rice-eclipse/AFSElec/README.md

This is the official GitHub Repo for Rice ECLIPSE AFS.
