rice-eclipse/AFSElec/IndividualFolders/Tyler/Main/3d models/RP2350A.stp

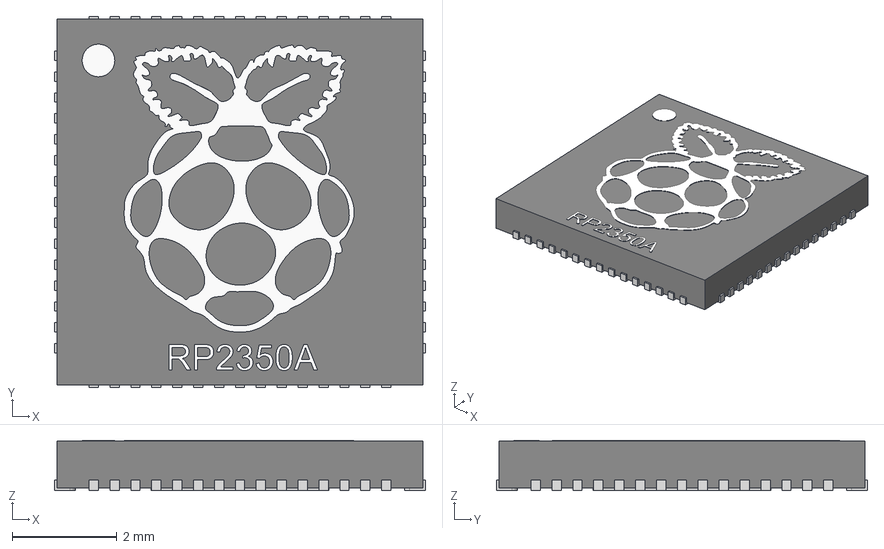
[picture p1: CAD file, 2026-02-24]
IndividualFolders/Tyler/Main/3d models/RP2350A.stp
7.10 x 7.10 x 0.96 mm
