rice-eclipse/AFSElec/IndividualFolders/Tyler/Main/3d models/Same_Sky_MSD-4-A.step

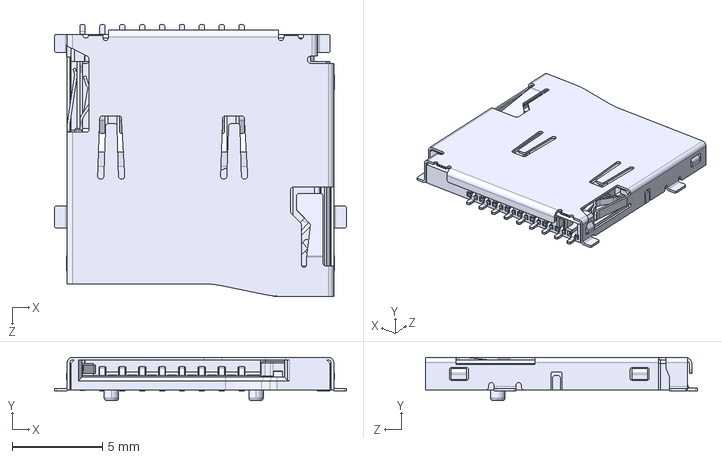
[picture p2: CAD file, 2026-02-20]
IndividualFolders/Tyler/Main/3d models/Same_Sky_MSD-4-A.step
16.1 x 2.40 x 15.0 mm
