rice-eclipse/AFSElec/IndividualFolders/Tyler/Main/3d models/10118193-0001lfc.stp

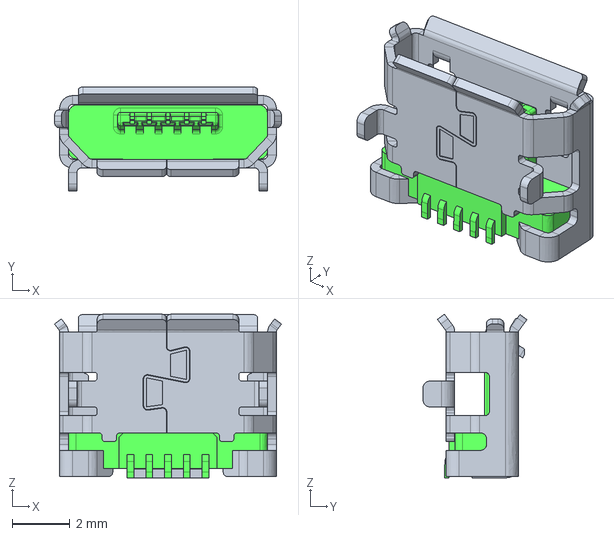
[picture p3: CAD file, 2026-02-20]
IndividualFolders/Tyler/Main/3d models/10118193-0001lfc.stp
7.86 x 3.60 x 5.66 mm
