rice-eclipse/AFSElec/Version2/Version2.kicad_pcb

## KiCad design Version2/Version2.kicad_pcb (2026-09-03)

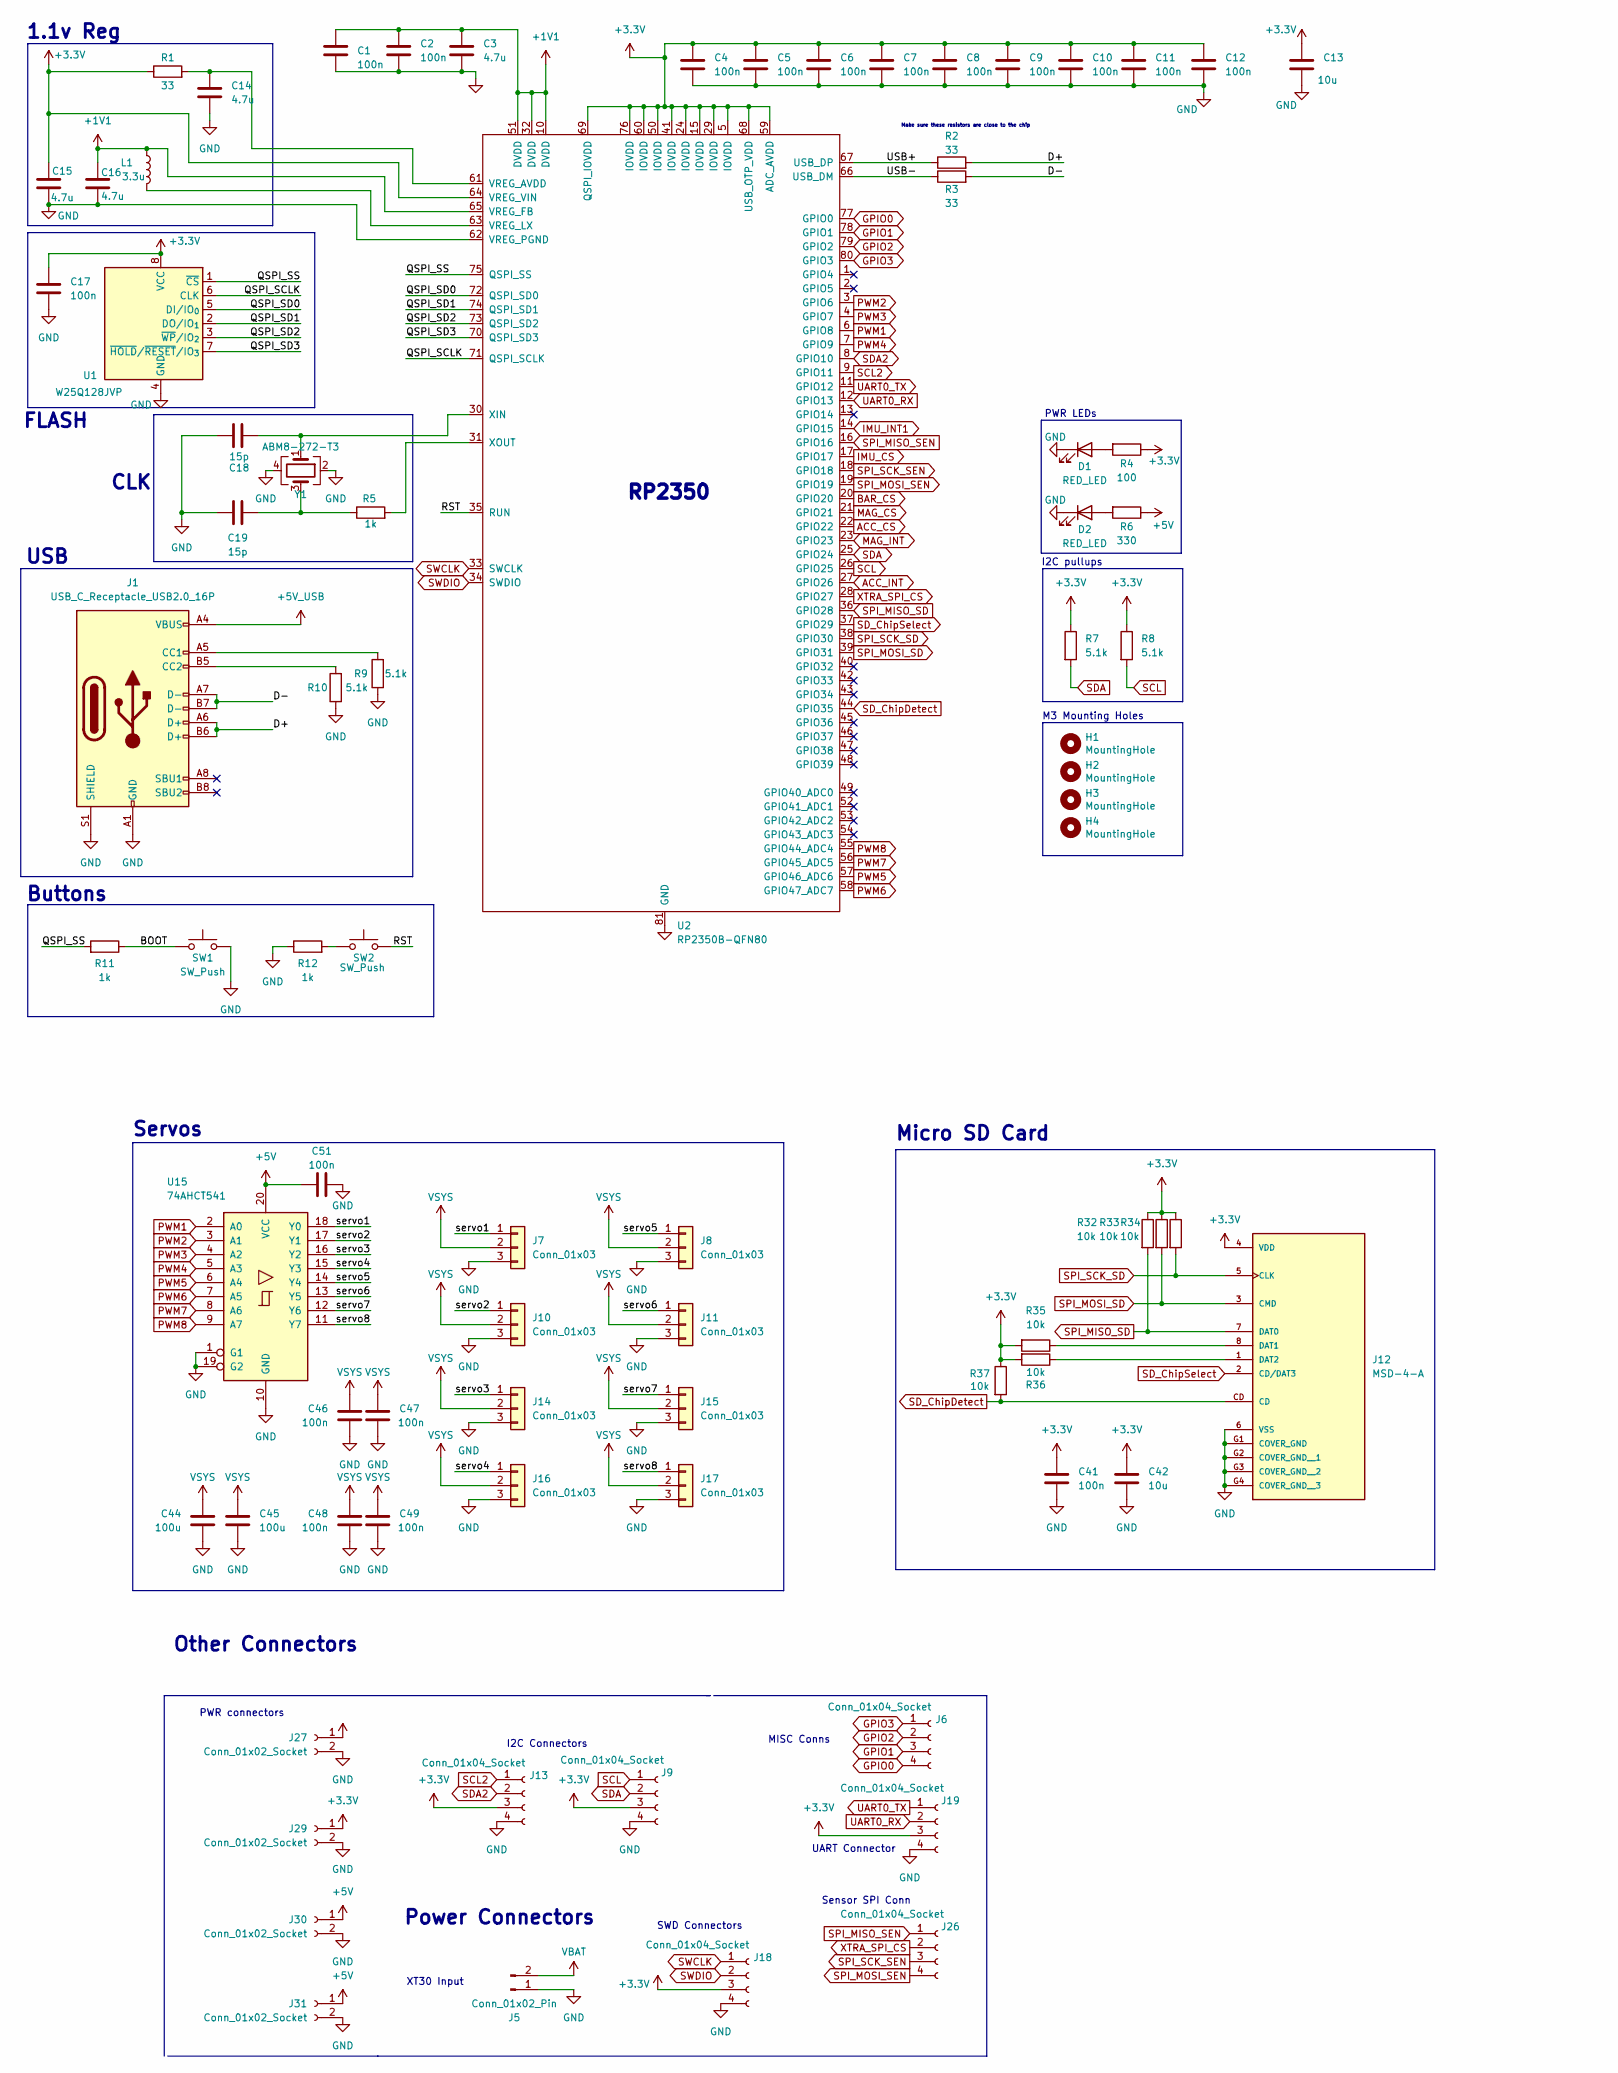
[picture p4: schematic Version2.kicad_sch, part in row 1, column 1]

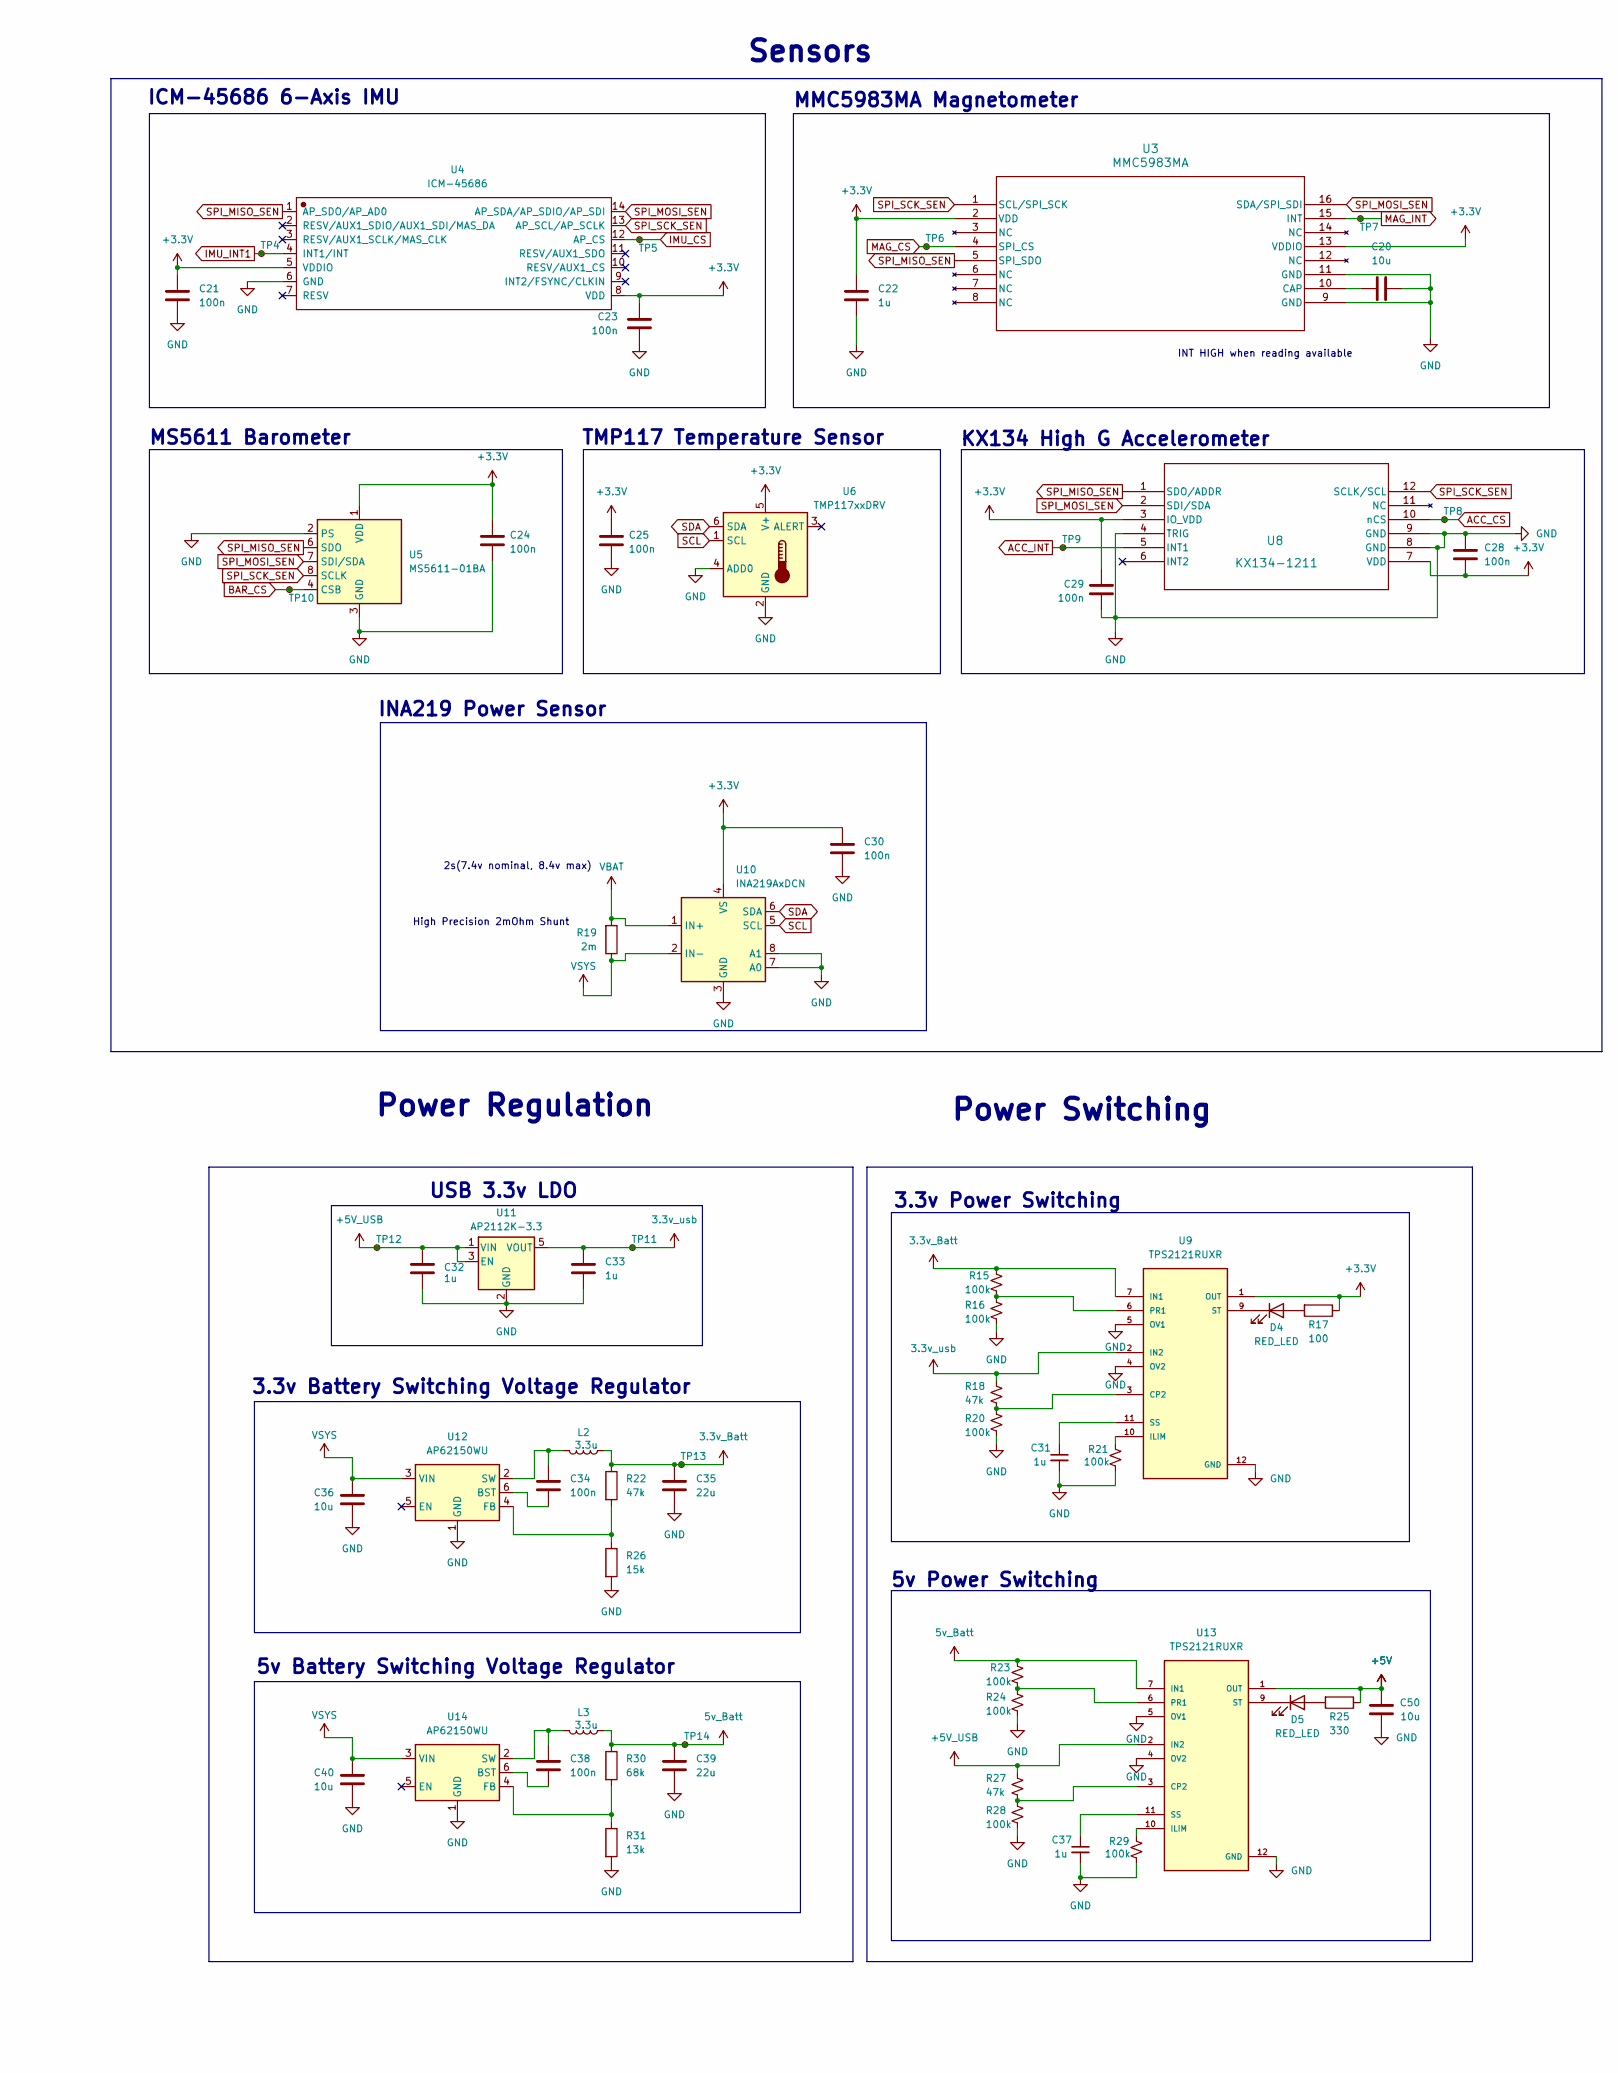
[picture p5: schematic Version2.kicad_sch, part in row 1, column 2]

Parts:
C1, C2, C4, C5, C6, C7, C8, C9, C10, C11, C12, C17, C21, C23, C24, C25, C28, C29, C30, C34, C38, C41, C46, C47, C48, C49, C51: 100n; C_0603_1608Metric; LCSC Part Number C14663
C3, C14, C15, C16: 4.7u; C_0805_2012Metric; LCSC Part Number C1779
C13, C20, C42: 10u; C_0805_2012Metric; LCSC Part Number C15850
C18, C19: 15p; C_0603_1608Metric; LCSC Part Number C1644
C22, C31, C32, C33, C37: 1u; C_0805_2012Metric; LCSC Part Number C28323
C35, C39: 22u; C_0805_2012Metric; LCSC Part Number C45783
C36, C40, C50: 10u; C_0805_2012Metric; JLCPCB Part # C15850
C44, C45: 100u; C_Radial_D5.0mm_H11.0mm_P2.00mm
D1, D2, D4, D5: RED_LED; LED_0805_2012Metric; LCSC Part Number C84256
H1, H2, H3, H4: MountingHole; MountingHole_3.2mm_M3_ISO14580_Pad
J1: USB_C_Receptacle_USB2.0_16P; USB_C_Receptacle_HRO_TYPE-C-31-M-12
J5: Conn_01x02_Pin; AMASS_XT30PW-M_1x02_P2.50mm_Horizontal
J6, J9, J13, J18, J19, J26: Conn_01x04_Socket; JST_PH_B4B-PH-K_1x04_P2.00mm_Vertical
J7, J8, J10, J11, J14, J15, J16, J17: Conn_01x03; PinHeader_1x03_P2.54mm_Vertical
J12: MSD-4-A; CUI_MSD-4-A; PARTREV 1.0; LCSC Part Number C22367949
J27, J29, J30, J31: Conn_01x02_Socket; JST_PH_B2B-PH-K_1x02_P2.00mm_Vertical
L1, L2, L3: 3.3u; AOTA-B201610S3R3-101-T(L_0806_2016metric); LCSC Part Number C42411119
R1, R2, R3: 33; R_0603_1608Metric; LCSC Part Number C23140
R4, R17: 100; R_0603_1608Metric; LCSC Part Number C22775
R5, R11, R12: 1k; R_0603_1608Metric; LCSC Part Number C21190
R6, R25: 330; R_0603_1608Metric; LCSC Part Number C23138
R7, R8, R9, R10: 5.1k; R_0603_1608Metric; LCSC Part Number C23186
R15, R16, R20, R21, R23, R24, R28, R29: 100k; R_0603_1608Metric; LCSC Part Number C25803
R18, R22, R27: 47k; R_0603_1608Metric; LCSC Part Number C25819
R19: 2m; R_1206_3216Metric
R26: 15k; R_0603_1608Metric; LCSC Part Number C22809
R30: 68k; R_0603_1608Metric; LCSC Part Number C23231
R31: 13k; R_0603_1608Metric; LCSC Part Number C22797
R32, R33, R34, R35, R36, R37: 10k; R_0603_1608Metric; LCSC Part Number C25804
SW1, SW2: SW_Push; SW_Push_SPST_NO_Alps_SKRK; LCSC Part Number C115357
TP4, TP5, TP6, TP7, TP8, TP9, TP10, TP11, TP12, TP13, TP14: TestPoint_Small; TestPoint_Pad_1.0x1.0mm
U1: W25Q128JVP; WSON-8-1EP_6x5mm_P1.27mm_EP3.4x4mm; LCSC Part Number C190862
U2: RP2350B-QFN80; QFN-80-1EP_10x10mm_P0.4mm_EP3.4x3.4mm; LCSC Part Number C42415655
U3: MMC5983MA; LGA-16_3x3mm_P0.5mm; LCSC Part Number C404329
U4: ICM-45686; Bosch_LGA-14_3x2.5mm_P0.5mm; Manufacturer Part ICM-45686; LCSC C22459454
U5: MS5611-01BA; LGA-8_3x5mm_P1.25mm; LCSC Part Number C15639
U6: TMP117xxDRV; WSON-6-1EP_2x2mm_P0.65mm_EP1x1.6mm; LCSC Part Number C699536
U8: KX134-1211; LGA-12_2x2mm_P0.5mm; LCSC Part Number C2157908
U9, U13: TPS2121RUXR; Texas_VQFN-HR-12_2x2.5mm_P0.5mm; LCSC Part Number C485916
U10: INA219AxDCN; SOT-23-8; LCSC Part Number SOT-23-8
U11: AP2112K-3.3; SOT-23-5; LCSC Part Number C23380830
U12, U14: AP62150WU; TSOT-23-6; LCSC Part Number C3194237
U15: 74AHCT541; SSOP-20_4.4x6.5mm_P0.65mm; LCSC Part Number C2675635
Y1: ABM8-272-T3; Crystal_SMD_3225-4Pin_3.2x2.5mm; LCSC Part Number C20625731

Connections:
3.3v_Batt: C35.1, L2.1, R15.1, R22.1, TP13.1, U9.7 (IN1)
3.3v_usb: C33.1, R18.1, TP11.1, U9.2 (IN2), U11.5 (VOUT)
5v_Batt: C39.1, L3.1, R23.1, R30.1, TP14.1, U13.7 (IN1)
+1V1: C1.1, C2.1, C3.1, C16.1, L1.1, U2.10 (DVDD), U2.32 (DVDD), U2.51 (DVDD), U2.65 (VREG_FB)
+3.3V: C4.1, C5.1, C6.1, C7.1, C8.1, C9.1, C10.1, C11.1, C12.1, C13.1, C15.1, C17.1, C21.1, C22.2, C23.1, C24.1, C25.1, C28.2, C29.1, C30.1, C41.1, C42.1, J9.3, J12.4 (VDD), J13.3, J18.3, J19.3, J27.1, J29.1, R1.1, R4.1, R7.1, R8.1, R17.1, R32.1, R33.1, R34.1, R35.2, R36.2, R37.1, U1.8 (VCC), U2.5 (IOVDD), U2.15 (IOVDD), U2.24 (IOVDD), U2.29 (IOVDD), U2.41 (IOVDD), U2.50 (IOVDD), U2.59 (ADC_AVDD), U2.60 (IOVDD), U2.64 (VREG_VIN), U2.68 (USB_OTP_VDD), U2.69 (QSPI_IOVDD), U2.76 (IOVDD), U3.2 (VDD), U3.13 (VDDIO), U4.5 (VDDIO), U4.8 (VDD), U5.1 (VDD), U6.5 (V+), U8.3 (IO_VDD), U8.7 (VDD), U9.1 (OUT), U9.8 (OUT), U10.4 (VS)
+5V: C50.1, C51.1, J30.1, J31.1, R6.1, R25.1, U13.1 (OUT), U13.8 (OUT), U15.20 (VCC)
+5V_USB: C32.1, J1.A4 (VBUS), J1.A9 (VBUS), J1.B4 (VBUS), J1.B9 (VBUS), R27.1, TP12.1, U11.1 (VIN), U11.3 (EN), U13.2 (IN2)
/BOOT: R11.1, SW1.2
/D+: J1.A6 (D+), J1.B6 (D+), R2.2
/D-: J1.A7 (D-), J1.B7 (D-), R3.2
/QSPI_SCLK: U1.6 (CLK), U2.71 (QSPI_SCLK)
/QSPI_SD0: U1.5 (DI/IO_{0}), U2.72 (QSPI_SD0)
/QSPI_SD1: U1.2 (DO/IO_{1}), U2.74 (QSPI_SD1)
/QSPI_SD2: U1.3 (~WP/IO_{2}), U2.73 (QSPI_SD2)
/QSPI_SD3: U1.7 (~HOLD/~RESET/IO_{3}), U2.70 (QSPI_SD3)
/QSPI_SS: R11.2, U1.1 (~CS), U2.75 (QSPI_SS)
/RST: SW2.2, U2.35 (RUN)
/USB+: R2.1, U2.67 (USB_DP)
/USB-: R3.1, U2.66 (USB_DM)
/servo1: J7.1, U15.18 (Y0)
/servo2: J10.1, U15.17 (Y1)
/servo3: J14.1, U15.16 (Y2)
/servo4: J16.1, U15.15 (Y3)
/servo5: J8.1, U15.14 (Y4)
/servo6: J11.1, U15.13 (Y5)
/servo7: J15.1, U15.12 (Y6)
/servo8: J17.1, U15.11 (Y7)
ACC_CS: TP8.1, U2.22 (GPIO22), U8.10 (nCS)
ACC_INT: TP9.1, U2.27 (GPIO26), U8.5 (INT1)
BAR_CS: TP10.1, U2.20 (GPIO20), U5.4 (CSB), U5.5 (CSB)
GND: C1.2, C2.2, C3.2, C4.2, C5.2, C6.2, C7.2, C8.2, C9.2, C10.2, C11.2, C12.2, C13.2, C14.2, C15.2, C16.2, C17.2, C18.1, C19.1, C20.2, C21.2, C22.1, C23.2, C24.2, C25.2, C28.1, C29.2, C30.2, C31.2, C32.2, C33.2, C35.2, C36.2, C37.2, C39.2, C40.2, C41.2, C42.2, C44.2, C45.2, C46.2, C47.2, C48.2, C49.2, C50.2, C51.2, D1.1 (K), D2.1 (K), J1.A1 (GND), J1.A12 (GND), J1.B1 (GND), J1.B12 (GND), J1.S1 (SHIELD), J5.1, J7.3, J8.3, J9.4, J10.3, J11.3, J12.6 (VSS), J12.G1 (COVER_GND), J12.G2 (COVER_GND__1), J12.G3 (COVER_GND__2), J12.G4 (COVER_GND__3), J13.4, J14.3, J15.3, J16.3, J17.3, J18.4, J19.4, J27.2, J29.2, J30.2, J31.2, R9.1, R10.1, R12.1, R16.2, R20.2, R21.2, R24.2, R26.2, R28.2, R29.2, R31.2, SW1.1, U1.4 (GND), U2.62 (VREG_PGND), U2.81 (GND), U3.9 (GND), U3.11 (GND), U4.6 (GND), U5.2 (PS), U5.3 (GND), U6.2 (GND), U6.4 (ADD0), U8.4 (TRIG), U8.8 (GND), U8.9 (GND), U9.4 (OV2), U9.5 (OV1), U9.12 (GND), U10.3 (GND), U10.7 (A0), U10.8 (A1), U11.2 (GND), U12.1 (GND), U13.4 (OV2), U13.5 (OV1), U13.12 (GND), U14.1 (GND), U15.1 (G1), U15.10 (GND), U15.19 (G2), Y1.2, Y1.4
GPIO0: J6.4, U2.77 (GPIO0)
GPIO1: J6.3, U2.78 (GPIO1)
GPIO2: J6.2, U2.79 (GPIO2)
GPIO3: J6.1, U2.80 (GPIO3)
IMU_CS: TP5.1, U2.17 (GPIO17), U4.12 (AP_CS)
IMU_INT1: TP4.1, U2.14 (GPIO15), U4.4 (INT1/INT)
MAG_CS: TP6.1, U2.21 (GPIO21), U3.4 (SPI_CS)
MAG_INT: TP7.1, U2.23 (GPIO23), U3.15 (INT)
unnamed: C19.2, R5.1, Y1.3
unnamed: D1.2 (A), R4.2
unnamed: D2.2 (A), R6.2
unnamed: D4.2 (A), R17.2
unnamed: D4.1 (K), U9.9 (ST)
unnamed: D5.2 (A), R25.2
unnamed: D5.1 (K), U13.9 (ST)
unnamed: J1.A5 (CC1), R9.2
unnamed: J1.B5 (CC2), R10.2
unnamed: J12.8 (DAT1), R35.1
unnamed: J12.1 (DAT2), R36.1
unnamed: R12.2, SW2.1
unnamed: C14.1, R1.2, U2.61 (VREG_AVDD)
unnamed: L1.2, U2.63 (VREG_LX)
unnamed: C18.2, U2.30 (XIN), Y1.1
unnamed: R5.2, U2.31 (XOUT)
unnamed: C20.1, U3.10 (CAP)
unnamed: R18.2, R20.1, U9.3 (CP2)
unnamed: R21.1, U9.10 (ILIM)
unnamed: R15.2, R16.1, U9.6 (PR1)
unnamed: C31.1, U9.11 (SS)
unnamed: C34.2, U12.6 (BST)
unnamed: R22.2, R26.1, U12.4 (FB)
unnamed: C34.1, L2.2, U12.2 (SW)
unnamed: R27.2, R28.1, U13.3 (CP2)
unnamed: R29.1, U13.10 (ILIM)
unnamed: R23.2, R24.1, U13.6 (PR1)
unnamed: C37.1, U13.11 (SS)
unnamed: C38.2, U14.6 (BST)
unnamed: R30.2, R31.1, U14.4 (FB)
unnamed: C38.1, L3.2, U14.2 (SW)
PWM1: U2.6 (GPIO8), U15.2 (A0)
PWM2: U2.3 (GPIO6), U15.3 (A1)
PWM3: U2.4 (GPIO7), U15.4 (A2)
PWM4: U2.7 (GPIO9), U15.5 (A3)
PWM5: U2.57 (GPIO46_ADC6), U15.6 (A4)
PWM6: U2.58 (GPIO47_ADC7), U15.7 (A5)
PWM7: U2.56 (GPIO45_ADC5), U15.8 (A6)
PWM8: U2.55 (GPIO44_ADC4), U15.9 (A7)
SCL: J9.1, R8.2, U2.26 (GPIO25), U6.1 (SCL), U10.5 (SCL)
SCL2: J13.1, U2.9 (GPIO11)
SDA: J9.2, R7.2, U2.25 (GPIO24), U6.6 (SDA), U10.6 (SDA)
SDA2: J13.2, U2.8 (GPIO10)
SD_ChipDetect: J12.CD, R37.2, U2.44 (GPIO35)
SD_ChipSelect: J12.2 (CD/DAT3), U2.37 (GPIO29)
SPI_MISO_SD: J12.7 (DAT0), R32.2, U2.36 (GPIO28)
SPI_MISO_SEN: J26.1, U2.16 (GPIO16), U3.5 (SPI_SDO), U4.1 (AP_SDO/AP_AD0), U5.6 (SDO), U8.1 (SDO/ADDR)
SPI_MOSI_SD: J12.3 (CMD), R33.2, U2.39 (GPIO31)
SPI_MOSI_SEN: J26.4, U2.19 (GPIO19), U3.16 (SDA/SPI_SDI), U4.14 (AP_SDA/AP_SDIO/AP_SDI), U5.7 (SDI/SDA), U8.2 (SDI/SDA)
SPI_SCK_SD: J12.5 (CLK), R34.2, U2.38 (GPIO30)
SPI_SCK_SEN: J26.3, U2.18 (GPIO18), U3.1 (SCL/SPI_SCK), U4.13 (AP_SCL/AP_SCLK), U5.8 (SCLK), U8.12 (SCLK/SCL)
SWCLK: J18.1, U2.33 (SWCLK)
SWDIO: J18.2, U2.34 (SWDIO)
UART0_RX: J19.2, U2.12 (GPIO13)
UART0_TX: J19.1, U2.11 (GPIO12)
VBAT: J5.2, R19.2, U10.1 (IN+)
VSYS: C36.1, C40.1, C44.1, C45.1, C46.1, C47.1, C48.1, C49.1, J7.2, J8.2, J10.2, J11.2, J14.2, J15.2, J16.2, J17.2, R19.1, U10.2 (IN-), U12.3 (VIN), U14.3 (VIN)
XTRA_SPI_CS: J26.2, U2.28 (GPIO27)

Notes on the sheet:
INT HIGH when reading available
USB 3.3v LDO
I2C Connectors
TMP117 Temperature Sensor
RP2350
Power Connectors
Buttons
5v Power Switching
3.3v Power Switching
Power Regulation
INA219 Power Sensor
Sensor SPI Conn
KX134 High G Accelerometer
ICM-45686 6-Axis IMU
Other Connectors
3.3v Battery Switching Voltage Regulator
2s(7.4v nominal, 8.4v max)
5v Battery Switching Voltage Regulator
SWD Connectors
CLK
Sensors
XT30 Input
I2C pullups
Make sure these resistors are close to the chip
M3 Mounting Holes
FLASH
MS5611 Barometer
High Precision 2mOhm Shunt
MMC5983MA Magnetometer
PWR LEDs
Power Switching
UART Connector
Servos
1.1v Reg
Micro SD Card
USB
PWR connectors
MISC Conns

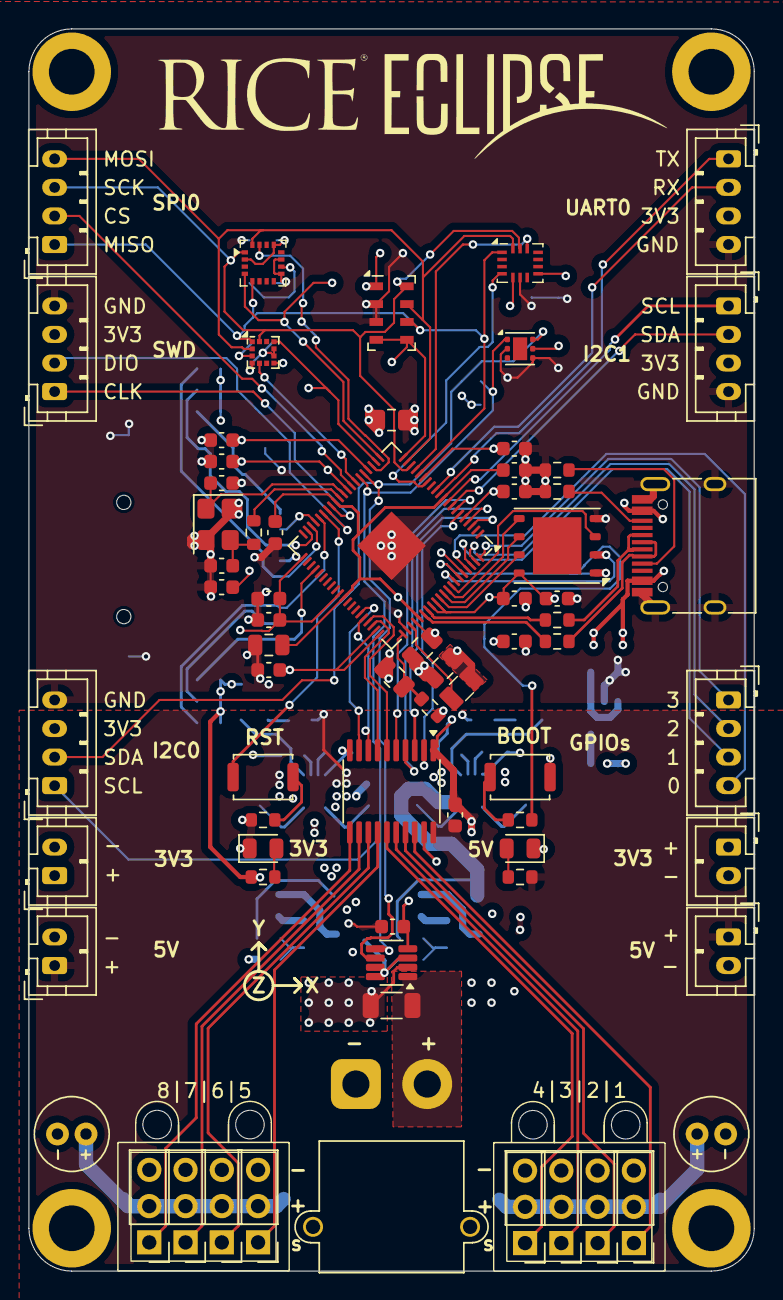
[picture p6: board Version2.kicad_pcb from above]

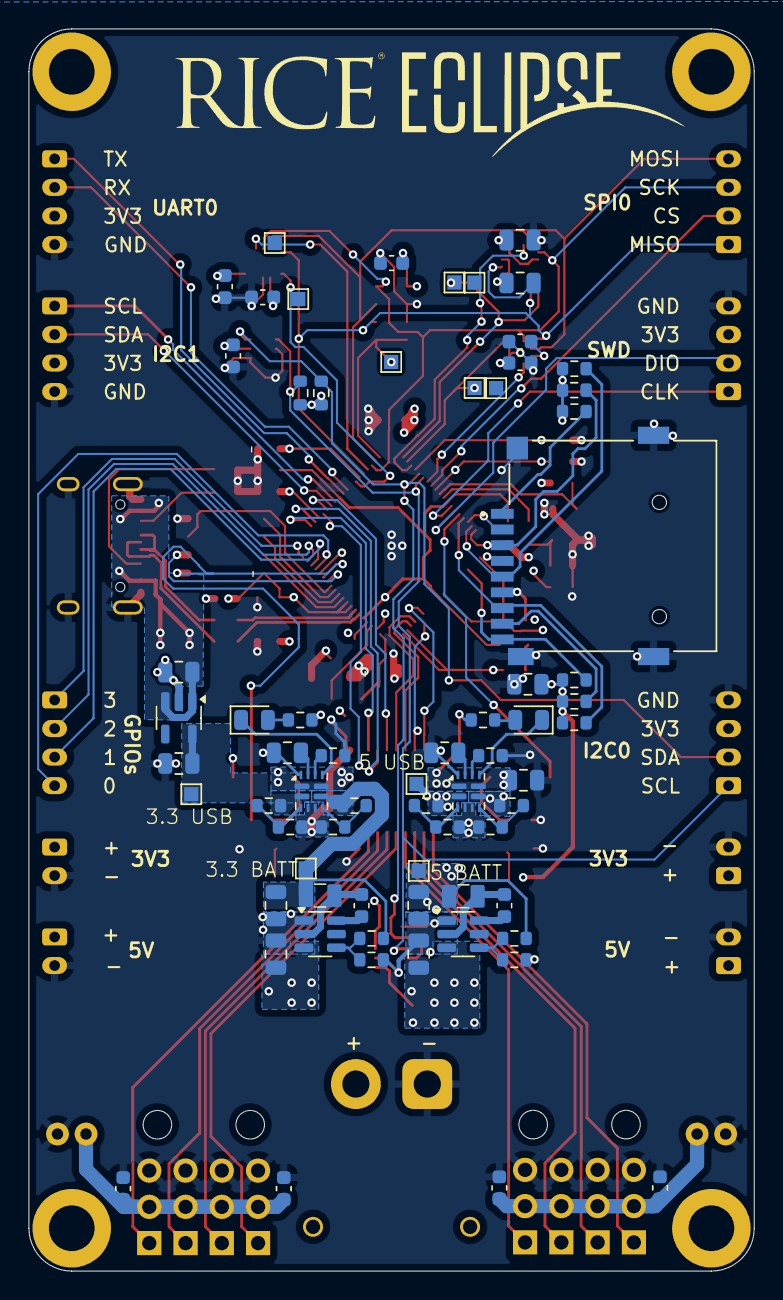
[picture p7: board Version2.kicad_pcb from below]

Board: 4 copper layers, 50.8 x 87.0 mm, 146 parts (69 on the bottom side), 97 nets.

Other parts of the board:
G1, G2: 3x4PinHeaderCase90deg
G3: orientationIndicator
