rice-eclipse/AFSElec/Main/Main.kicad_pcb

## KiCad design Main/Main.kicad_pcb (2026-07-12)

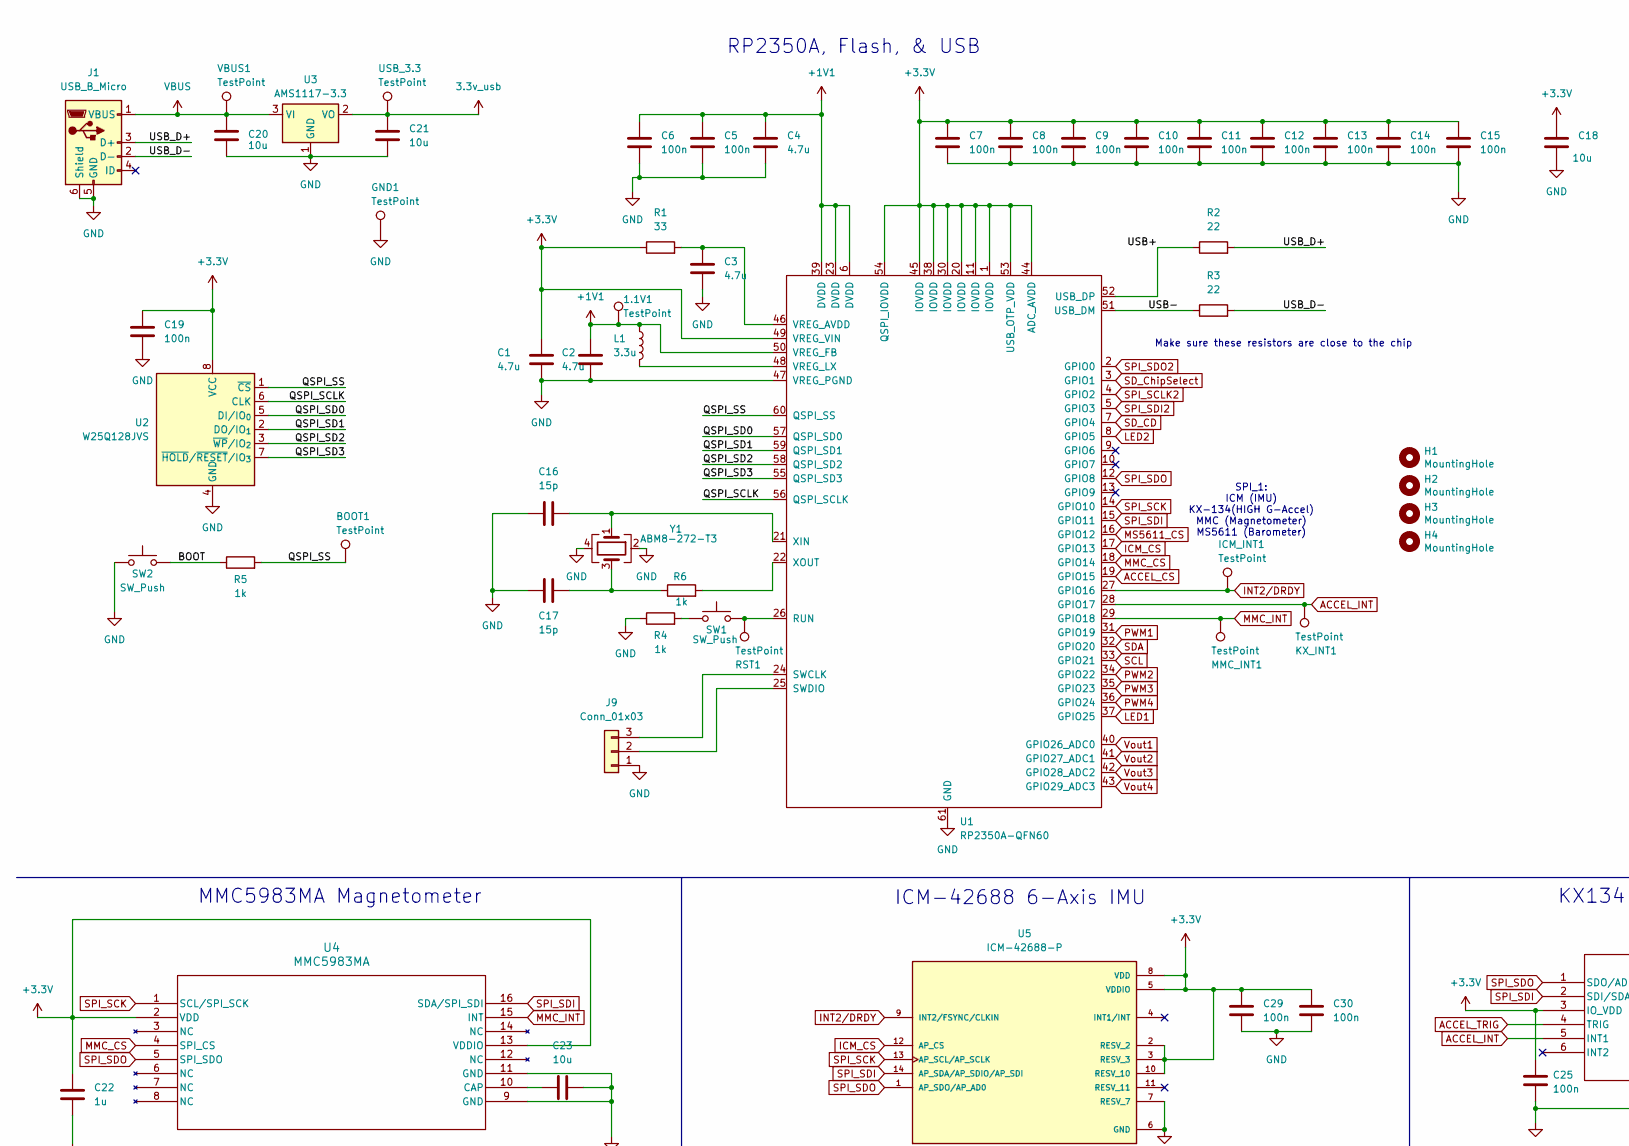
[picture p8: schematic Main.kicad_sch, part in row 1, column 1]

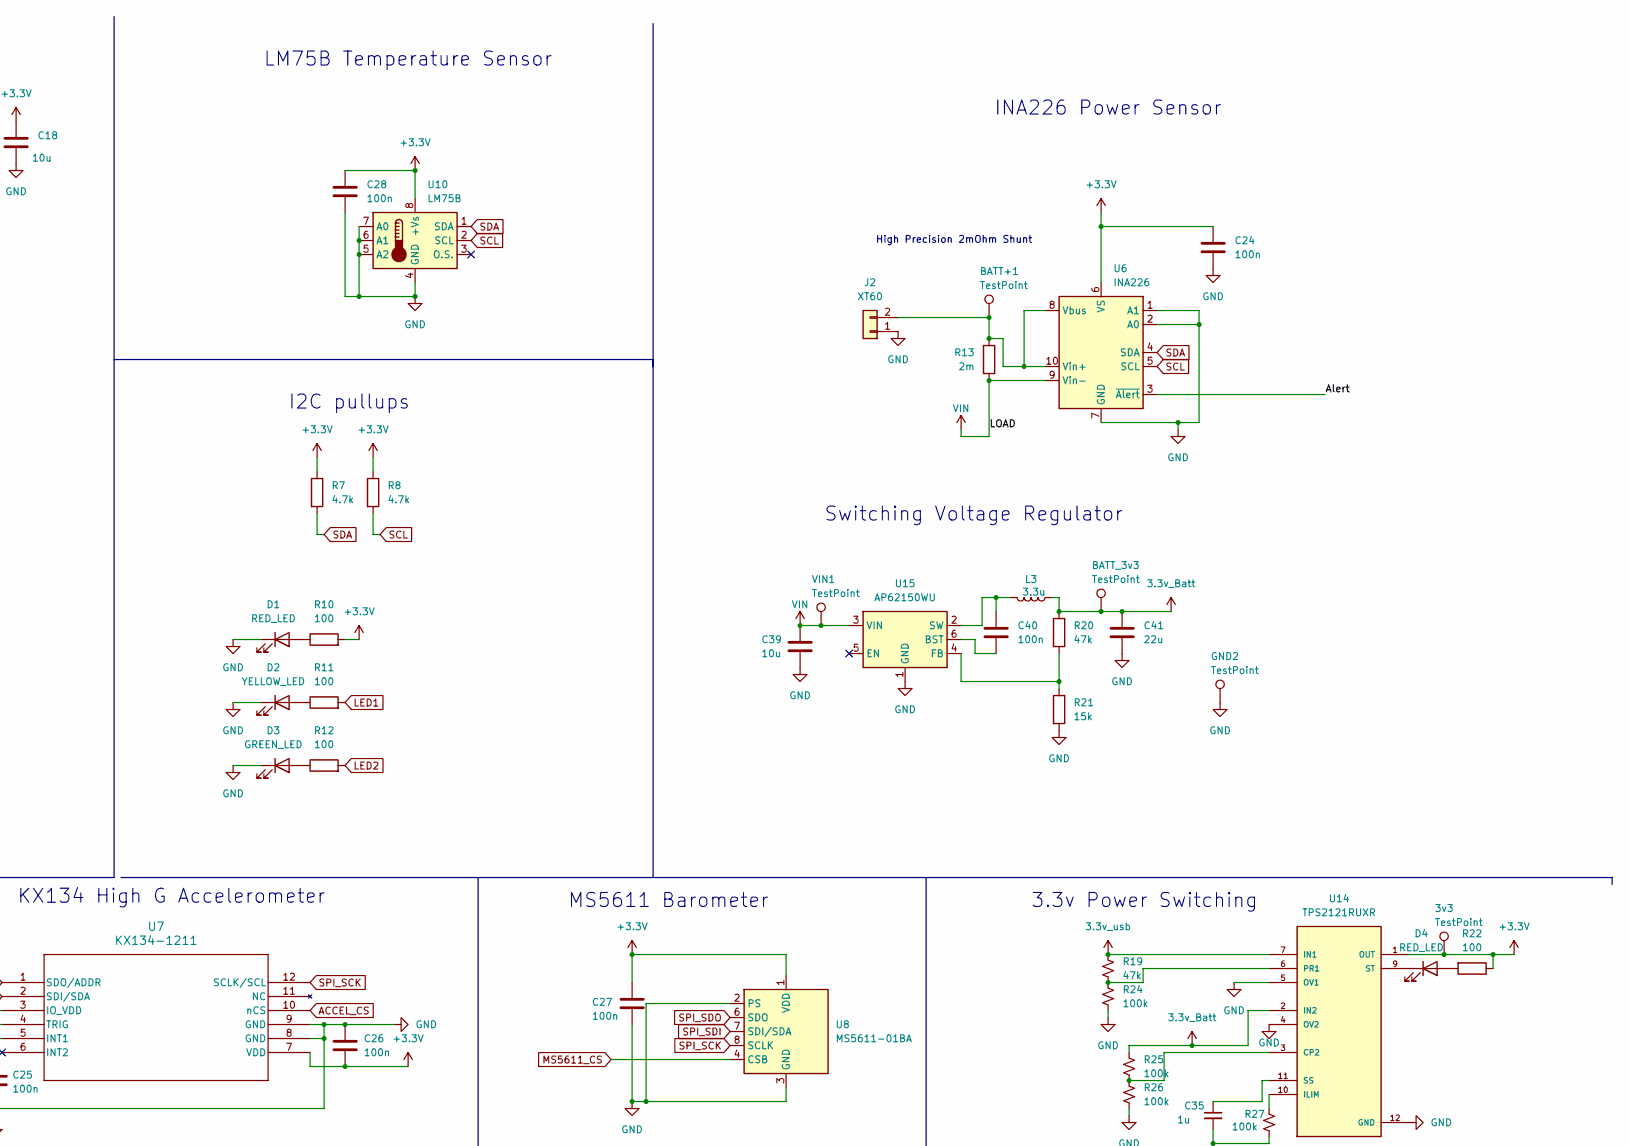
[picture p9: schematic Main.kicad_sch, part in row 1, column 2]

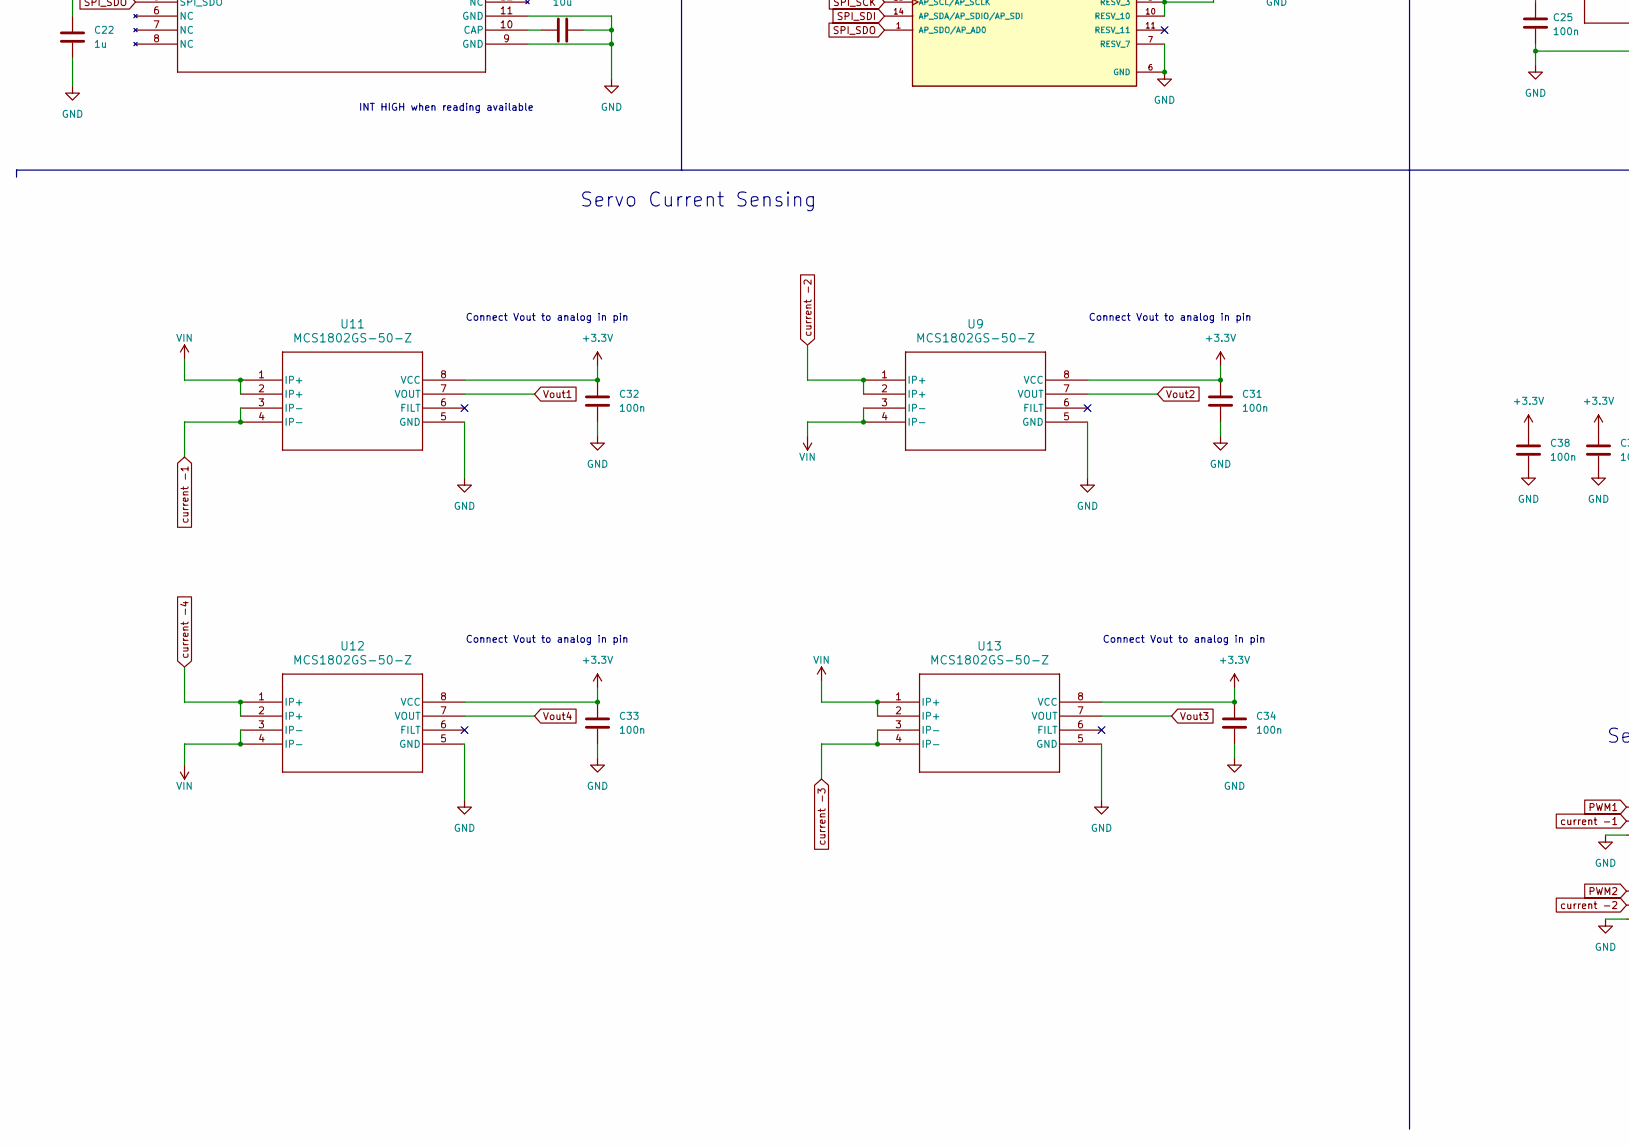
[picture p10: schematic Main.kicad_sch, part in row 2, column 1]

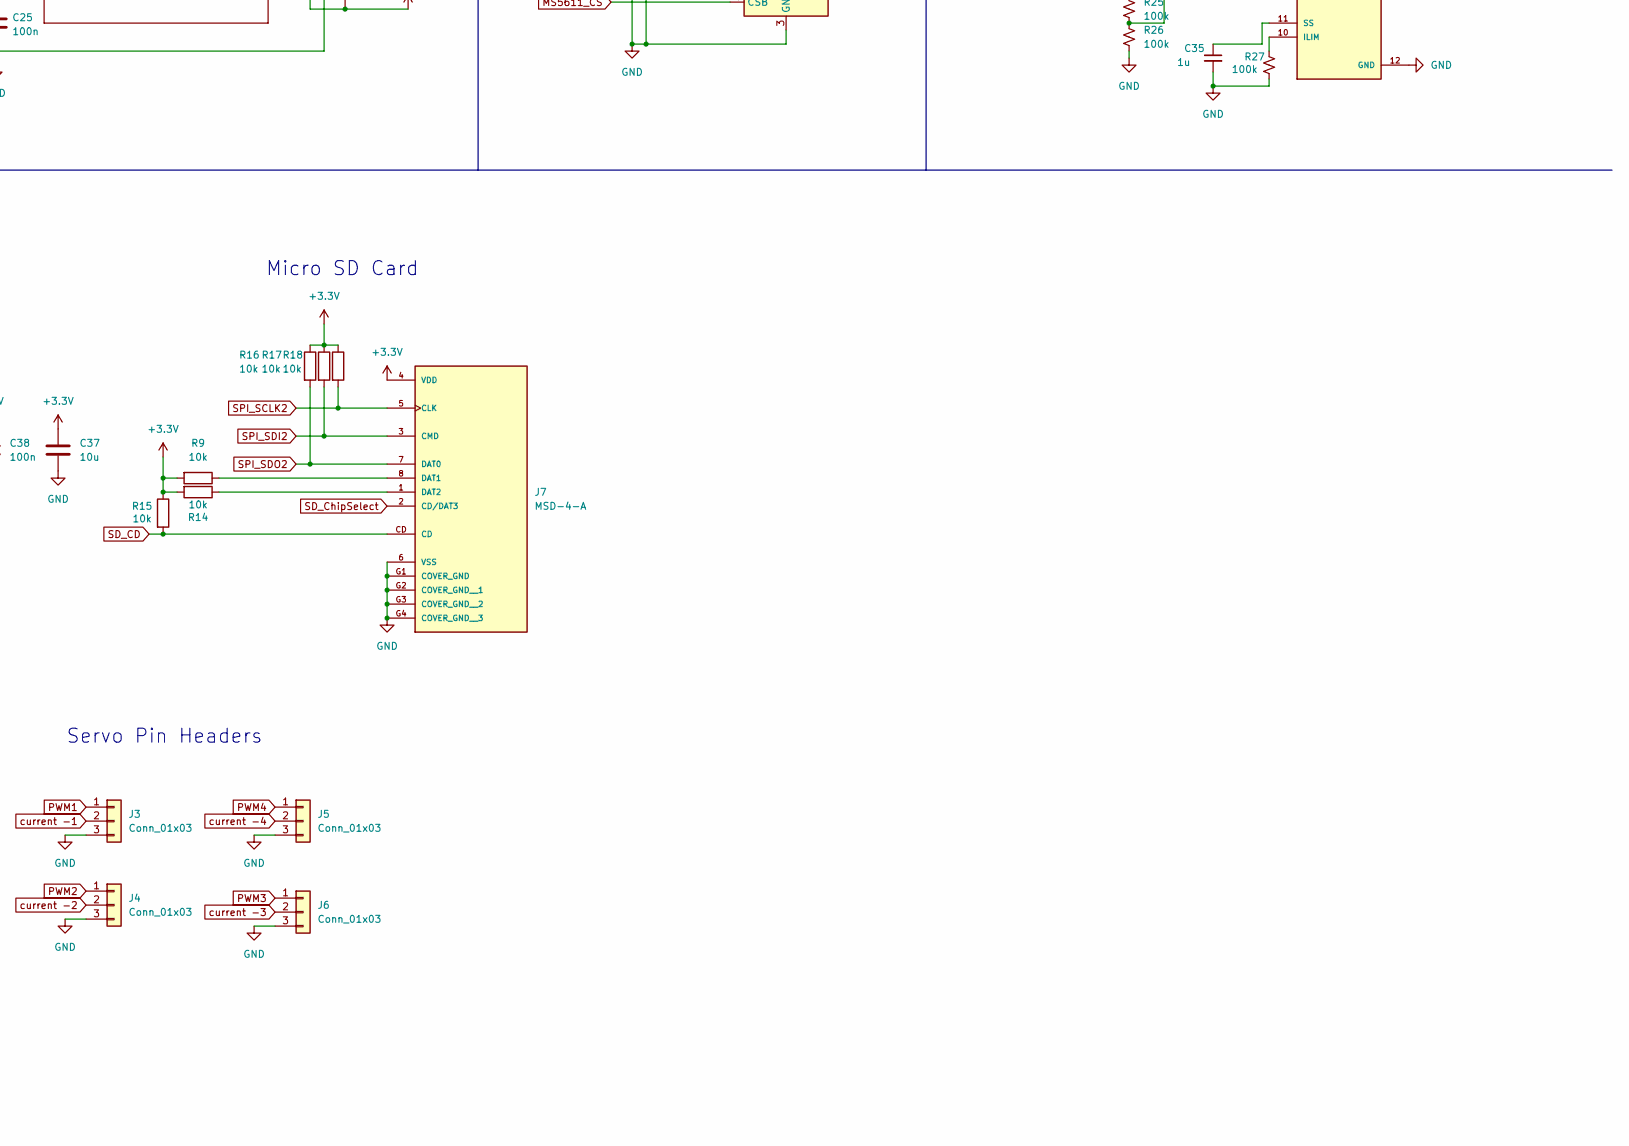
[picture p11: schematic Main.kicad_sch, part in row 2, column 2]

Parts:
1.1V1, 3v3: TestPoint; TestPoint_Pad_D1.0mm
BATT+1: TestPoint; TestPoint_Pad_D1.0mm
BATT_3v3: TestPoint; TestPoint_Pad_D1.0mm
BOOT1: TestPoint; TestPoint_Pad_D1.0mm
C1, C2, C3, C4: 4.7u; C_0402_1005Metric; LCSC Part Number C23733
C5, C6, C7, C8, C9, C10, C11, C12, C13, C14, C15, C19, C24, C25, C26, C27, C28, C29, C30, C31, C32, C33, C34, C38, C40: 100n; C_0402_1005Metric; LCSC Part Number C1525
C16, C17: 15p; C_0402_1005Metric; LCSC Part Number C1548
C18, C20, C21, C23, C37: 10u; C_0805_2012Metric; LCSC Part Number C15850
C22, C35: 1u; C_0805_2012Metric; LCSC Part Number C28323
C39: 10u; C_0805_2012Metric; JLCPCB Part # C15850
C41: 22u; C_0805_2012Metric; LCSC Part Number C45783
D1, D4: RED_LED; LED_0805_2012Metric; LCSC Part Number C84256
D2: YELLOW_LED; LED_0805_2012Metric; LCSC Part Number C2296
D3: GREEN_LED; LED_0805_2012Metric; LCSC Part Number C2297
GND1, GND2: TestPoint; TestPoint_Pad_D1.0mm
H1, H2, H3, H4: MountingHole; MountingHole_3.2mm_M3_ISO14580_Pad
ICM_INT1: TestPoint; TestPoint_Pad_D1.0mm
J1: USB_B_Micro; USB_Micro-B_Amphenol_10118193-0001LF_Horizontal
J2: XT60; AMASS_XT60-M_1x02_P7.20mm_Vertical
J3, J4, J5, J6, J9: Conn_01x03; PinHeader_1x03_P2.54mm_Vertical
J7: MSD-4-A; CUI_MSD-4-A; PARTREV 1.0
KX_INT1: TestPoint; TestPoint_Pad_D1.0mm
L1, L3: 3.3u; AOTA-B201610S3R3-101-T(L_0806_2016metric)
MMC_INT1: TestPoint; TestPoint_Pad_D1.0mm
R1: 33; R_0402_1005Metric; LCSC Part Number C25105
R2, R3: 22; R_0402_1005Metric; LCSC Part Number C25092
R4, R5, R6: 1k; R_0402_1005Metric; LCSC Part Number C11702
R7, R8: 4.7k; R_0402_1005Metric; LCSC Part Number C25900
R9, R14, R15, R16, R17, R18: 10k; R_0402_1005Metric; LCSC Part Number C25744
R10, R11, R12, R22: 100; R_0402_1005Metric; LCSC Part Number C25076
R13: 2m; R_1206_3216Metric
R19, R20: 47k; R_0402_1005Metric; LCSC Part Number C25792
R21: 15k; R_0402_1005Metric; LCSC Part Number C25756
R24, R25, R26, R27: 100k; R_0402_1005Metric; LCSC Part Number C25741
RST1: TestPoint; TestPoint_Pad_D1.0mm
SW1, SW2: SW_Push; SW_Push_SPST_NO_Alps_SKRK
U1: RP2350A-QFN60; QFN-60-1EP_7x7mm_P0.4mm_EP3.4x3.4mm; LCSC Part Number C42411118
U2: W25Q128JVS; SOIC-8_5.3x5.3mm_P1.27mm; LCSC Part Number C97521
U3: AMS1117-3.3; SOT-223-3_TabPin2; LCSC Part Number C6186
U4: MMC5983MA; LGA-16_3x3mm_P0.5mm; LCSC Part Number C404329
U5: ICM-42688-P; LGA-14_3x2.5mm_P0.5mm_LayoutBorder3x4y; PARTREV 1.2; LCSC Part Number C48586483
U6: INA226; VSSOP-10_3x3mm_P0.5mm; LCSC Part Number C49851
U7: KX134-1211; LGA-12_2x2mm_P0.5mm; LCSC Part Number C2157908
U8: MS5611-01BA; LGA-8_3x5mm_P1.25mm; LCSC Part Number C15639
U9, U11, U12, U13: MCS1802GS-50-Z; SOIC-8-1EP_3.9x4.9mm_P1.27mm_EP2.29x3mm; LCSC Part Number C3684509
U10: LM75B; SOIC-8-1EP_3.9x4.9mm_P1.27mm_EP2.29x3mm; LCSC Part Number C34565
U14: TPS2121RUXR; Texas_VQFN-HR-12_2x2.5mm_P0.5mm; LCSC Part Number C485916
U15: AP62150WU; TSOT-23-6; LCSC Part Number C3194237
USB_3.3: TestPoint; TestPoint_Pad_D1.0mm
VBUS1: TestPoint; TestPoint_Pad_D1.0mm
VIN1: TestPoint; TestPoint_Pad_D1.0mm
Y1: ABM8-272-T3; Crystal_SMD_3225-4Pin_3.2x2.5mm; LCSC Part Number C20625731

Connections:
3.3v_Batt: BATT_3v3.1, C41.1, L3.1, R20.1, R25.1, U14.2 (IN2)
3.3v_usb: C21.1, R19.1, U3.2 (VO), U14.7 (IN1), USB_3.3.1
+1V1: 1.1V1.1, C2.1, C4.1, C5.1, C6.1, L1.1, U1.6 (DVDD), U1.23 (DVDD), U1.39 (DVDD), U1.50 (VREG_FB)
+3.3V: 3v3.1, C1.1, C7.1, C8.1, C9.1, C10.1, C11.1, C12.1, C13.1, C14.1, C15.1, C18.1, C19.1, C22.2, C24.1, C25.1, C26.2, C27.1, C28.1, C29.1, C30.1, C31.1, C32.1, C33.1, C34.1, C37.1, C38.1, J7.4 (VDD), R1.1, R7.1, R8.1, R9.2, R10.2, R14.2, R15.1, R16.1, R17.1, R18.1, R22.1, U1.1 (IOVDD), U1.11 (IOVDD), U1.20 (IOVDD), U1.30 (IOVDD), U1.38 (IOVDD), U1.44 (ADC_AVDD), U1.45 (IOVDD), U1.49 (VREG_VIN), U1.53 (USB_OTP_VDD), U1.54 (QSPI_IOVDD), U2.8 (VCC), U4.2 (VDD), U4.13 (VDDIO), U5.2 (RESV_2), U5.3 (RESV_3), U5.5 (VDDIO), U5.8 (VDD), U5.10 (RESV_10), U6.6 (VS), U7.3 (IO_VDD), U7.7 (VDD), U8.1 (VDD), U9.8 (VCC), U10.8 (+Vs), U11.8 (VCC), U12.8 (VCC), U13.8 (VCC), U14.1 (OUT), U14.8 (OUT)
/Alert: U6.3 (~Alert)
/BOOT: R5.1, SW2.2
/QSPI_SCLK: U1.56 (QSPI_SCLK), U2.6 (CLK)
/QSPI_SD0: U1.57 (QSPI_SD0), U2.5 (DI/IO_{0})
/QSPI_SD1: U1.59 (QSPI_SD1), U2.2 (DO/IO_{1})
/QSPI_SD2: U1.58 (QSPI_SD2), U2.3 (~WP/IO_{2})
/QSPI_SD3: U1.55 (QSPI_SD3), U2.7 (~HOLD/~RESET/IO_{3})
/QSPI_SS: BOOT1.1, R5.2, U1.60 (QSPI_SS), U2.1 (~CS); also elsewhere on the board
/USB+: R2.1, U1.52 (USB_DP)
/USB-: R3.1, U1.51 (USB_DM)
/USB_D+: J1.3 (D+), R2.2
/USB_D-: J1.2 (D-), R3.2
ACCEL_CS: U1.19 (GPIO15), U7.10 (nCS)
ACCEL_INT: KX_INT1.1, U1.28 (GPIO17), U7.5 (INT1); also elsewhere on the board
ACCEL_TRIG: U7.4 (TRIG)
GND: C1.2, C2.2, C3.2, C4.2, C5.2, C6.2, C7.2, C8.2, C9.2, C10.2, C11.2, C12.2, C13.2, C14.2, C15.2, C16.1, C17.1, C18.2, C19.2, C20.2, C21.2, C22.1, C23.2, C24.2, C25.2, C26.1, C27.2, C28.2, C29.2, C30.2, C31.2, C32.2, C33.2, C34.2, C35.2, C37.2, C38.2, C39.2, C41.2, D1.1 (K), D2.1 (K), D3.1 (K), GND1.1, GND2.1, H1.1, H2.1, H3.1, H4.1, J1.5 (GND), J1.6 (Shield), J2.1, J3.3, J4.3, J5.3, J6.3, J7.6 (VSS), J7.G1 (COVER_GND), J7.G2 (COVER_GND__1), J7.G3 (COVER_GND__2), J7.G4 (COVER_GND__3), J9.1, R4.1, R21.2, R24.2, R26.2, R27.2, SW2.1, U1.47 (VREG_PGND), U1.61 (GND), U2.4 (GND), U3.1 (GND), U4.9 (GND), U4.11 (GND), U5.6 (GND), U5.7 (RESV_7), U6.1 (A1), U6.2 (A0), U6.7 (GND), U7.8 (GND), U7.9 (GND), U8.2 (PS), U8.3 (GND), U9.5 (GND), U10.4 (GND), U10.5 (A2), U10.6 (A1), U10.7 (A0), U11.5 (GND), U12.5 (GND), U13.5 (GND), U14.4 (OV2), U14.5 (OV1), U14.12 (GND), U15.1 (GND), Y1.2, Y1.4; also elsewhere on the board
ICM_CS: U1.17 (GPIO13), U5.12 (AP_CS)
INT2/DRDY: ICM_INT1.1, U1.27 (GPIO16), U5.9 (INT2/FSYNC/CLKIN); also elsewhere on the board
LED1: R11.2, U1.37 (GPIO25)
LED2: R12.2, U1.8 (GPIO5)
MMC_CS: U1.18 (GPIO14), U4.4 (SPI_CS)
MMC_INT: MMC_INT1.1, U1.29 (GPIO18), U4.15 (INT); also elsewhere on the board
MS5611_CS: U1.16 (GPIO12), U8.4 (CSB), U8.5 (CSB)
unnamed: C17.2, R6.1, Y1.3
unnamed: D1.2 (A), R10.1
unnamed: D2.2 (A), R11.1
unnamed: D3.2 (A), R12.1
unnamed: D4.2 (A), R22.2
unnamed: D4.1 (K), U14.9 (ST)
unnamed 33: BATT+1.1, J2.2, R13.2, U6.8 (Vbus), U6.10 (Vin+); also elsewhere on the board
unnamed: J7.8 (DAT1), R9.1
unnamed: J7.1 (DAT2), R14.1
unnamed: J9.2, U1.25 (SWDIO)
unnamed: J9.3, U1.24 (SWCLK)
unnamed: R4.2, SW1.1
unnamed 39: RST1.1, SW1.2, U1.26 (RUN); also elsewhere on the board
unnamed: C3.1, R1.2, U1.46 (VREG_AVDD)
unnamed: L1.2, U1.48 (VREG_LX)
unnamed: C16.2, U1.21 (XIN), Y1.1
unnamed: R6.2, U1.22 (XOUT)
unnamed: C23.1, U4.10 (CAP)
unnamed: R25.2, R26.1, U14.3 (CP2)
unnamed: R27.1, U14.10 (ILIM)
unnamed: R19.2, R24.1, U14.6 (PR1)
unnamed: C35.1, U14.11 (SS)
unnamed: C40.2, U15.6 (BST)
unnamed: R20.2, R21.1, U15.4 (FB)
unnamed: C40.1, L3.2, U15.2 (SW)
PWM1: J3.1, U1.31 (GPIO19)
PWM2: J4.1, U1.34 (GPIO22)
PWM3: J6.1, U1.35 (GPIO23)
PWM4: J5.1, U1.36 (GPIO24)
SCL: R8.2, U1.33 (GPIO21), U6.5 (SCL), U10.2 (SCL)
SDA: R7.2, U1.32 (GPIO20), U6.4 (SDA), U10.1 (SDA)
SD_CD: J7.CD, R15.2, U1.7 (GPIO4)
SD_ChipSelect: J7.2 (CD/DAT3), U1.3 (GPIO1)
SPI_SCK: U1.14 (GPIO10), U4.1 (SCL/SPI_SCK), U5.13 (AP_SCL/AP_SCLK), U7.12 (SCLK/SCL), U8.8 (SCLK)
SPI_SCLK2: J7.5 (CLK), R18.2, U1.4 (GPIO2)
SPI_SDI: U1.15 (GPIO11), U4.16 (SDA/SPI_SDI), U5.14 (AP_SDA/AP_SDIO/AP_SDI), U7.2 (SDI/SDA), U8.7 (SDI/SDA)
SPI_SDI2: J7.3 (CMD), R17.2, U1.5 (GPIO3)
SPI_SDO: U1.12 (GPIO8), U4.5 (SPI_SDO), U5.1 (AP_SDO/AP_AD0), U7.1 (SDO/ADDR), U8.6 (SDO)
SPI_SDO2: J7.7 (DAT0), R16.2, U1.2 (GPIO0)
VBUS: C20.1, J1.1 (VBUS), U3.3 (VI), VBUS1.1; also elsewhere on the board
VIN: C39.1, R13.1, U6.9 (Vin-), U9.3 (IP-), U9.4 (IP-), U11.1 (IP+), U11.2 (IP+), U12.3 (IP-), U12.4 (IP-), U13.1 (IP+), U13.2 (IP+), U15.3 (VIN), VIN1.1; also elsewhere on the board
Vout1: U1.40 (GPIO26_ADC0), U11.7 (VOUT)
Vout2: U1.41 (GPIO27_ADC1), U9.7 (VOUT)
Vout3: U1.42 (GPIO28_ADC2), U13.7 (VOUT)
Vout4: U1.43 (GPIO29_ADC3), U12.7 (VOUT)
current -1: J3.2, U11.3 (IP-), U11.4 (IP-)
current -2: J4.2, U9.1 (IP+), U9.2 (IP+)
current -3: J6.2, U13.3 (IP-), U13.4 (IP-)
current -4: J5.2, U12.1 (IP+), U12.2 (IP+)

Notes on the sheet:
MMC5983MA Magnetometer
I2C pullups
RP2350A, Flash, & USB
Servo Current Sensing
Servo Pin Headers
Connect Vout to analog in pin
LM75B Temperature Sensor
SPI_1: ICM (IMU) KX-134(HIGH G-Accel) MMC (Magnetometer) MS5611 (Barometer)
Switching Voltage Regulator
High Precision 2mOhm Shunt
INT HIGH when reading available
Micro SD Card
INA226 Power Sensor
ICM-42688 6-Axis IMU
KX134 High G Accelerometer
MS5611 Barometer
3.3v Power Switching
Make sure these resistors are close to the chip

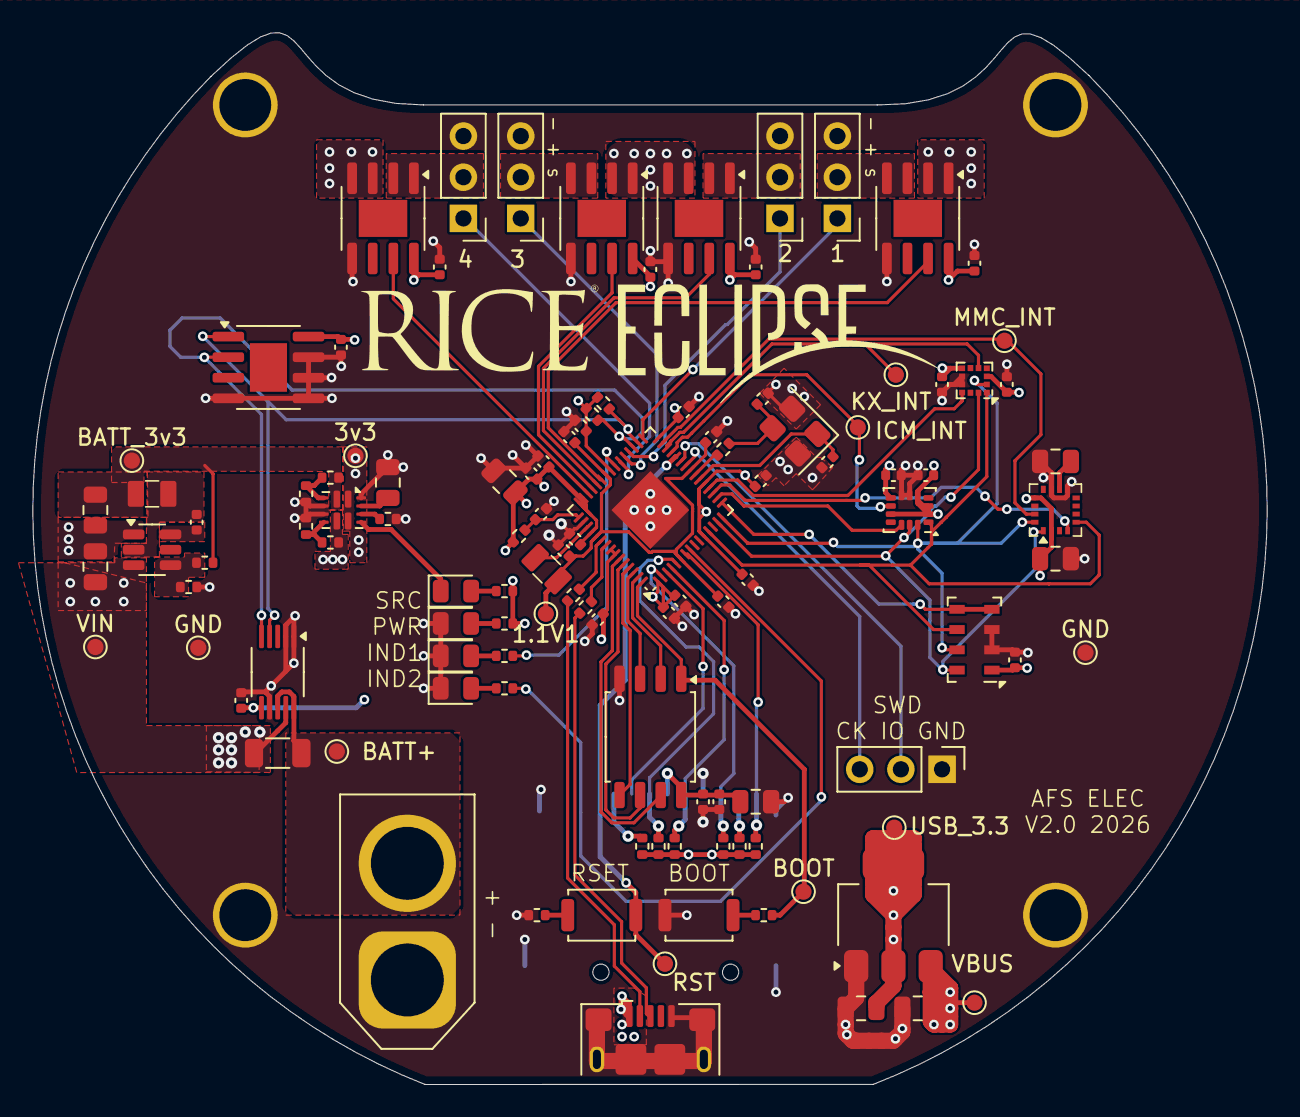
[picture p12: board Main.kicad_pcb from above]

Board: 4 copper layers, 76.2 x 64.9 mm, 116 parts (1 on the bottom side), 74 nets.

Other parts of the board:
BATT+: TestPoint; TestPoint_Pad_D1.0mm
BOOT: TestPoint; TestPoint_Pad_D1.0mm
GND: TestPoint; TestPoint_Pad_D1.0mm
GND#2: TestPoint; TestPoint_Pad_D1.0mm
ICM_INT: TestPoint; TestPoint_Pad_D1.0mm
KX_INT: TestPoint; TestPoint_Pad_D1.0mm
MMC_INT: TestPoint; TestPoint_Pad_D1.0mm
RST: TestPoint; TestPoint_Pad_D1.0mm
VBUS: TestPoint; TestPoint_Pad_D1.0mm
VIN: TestPoint; TestPoint_Pad_D1.0mm

Their connections:
/QSPI_SS: BOOT.1; also elsewhere on the board
ACCEL_INT: KX_INT.1; also elsewhere on the board
GND: GND.1, GND#2.1; also elsewhere on the board
INT2/DRDY: ICM_INT.1; also elsewhere on the board
MMC_INT: MMC_INT.1; also elsewhere on the board
unnamed 33: BATT+.1; also elsewhere on the board
unnamed 39: RST.1; also elsewhere on the board
VBUS: VBUS.1; also elsewhere on the board
VIN: VIN.1; also elsewhere on the board
