rice-eclipse/AFSElec/IndividualFolders/TPS2121 (Reza + Arda)/TPS2121/TPS2121.kicad_pcb

## KiCad design IndividualFolders/TPS2121 (Reza + Arda)/TPS2121/TPS2121.kicad_pcb (2026-02-27)

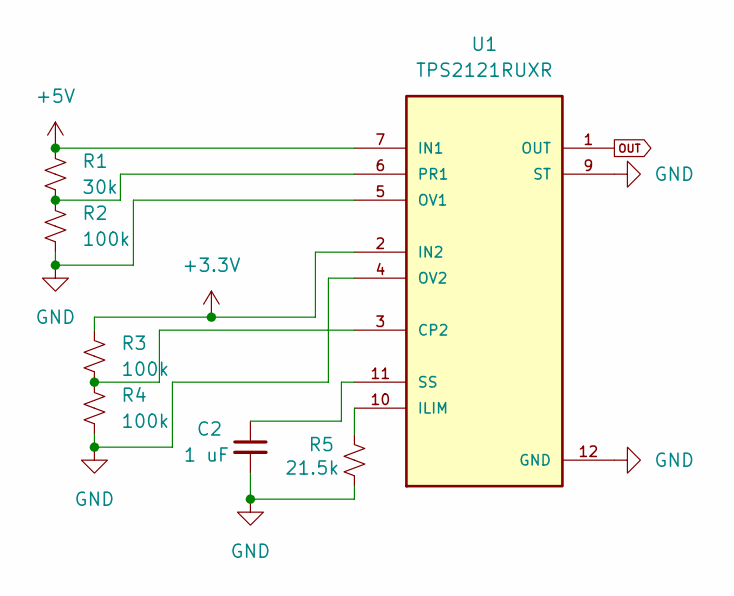
[picture p13: schematic TPS2121.kicad_sch]

Parts:
C2: 1 uF; C_0805_2012Metric
R1: 30k; R_0805_2012Metric
R2, R3, R4: 100k; R_0805_2012Metric
R5: 21.5k; R_0805_2012Metric
U1: TPS2121RUXR; IC_TPS2121RUXR

Connections:
+3.3V: R3.1, U1.2 (IN2), U1.2_1 (IN2)
+5V: R1.1, U1.7 (IN1), U1.7_1 (IN1)
GND: C2.2, R2.2, R4.2, R5.2, U1.4 (OV2), U1.5 (OV1), U1.9 (ST), U1.12 (GND)
unnamed: R3.2, R4.1, U1.3 (CP2)
unnamed: R5.1, U1.10 (ILIM)
unnamed: R1.2, R2.1, U1.6 (PR1)
unnamed: C2.1, U1.11 (SS)
OUT: U1.1 (OUT), U1.1_1 (OUT), U1.8 (OUT), U1.8_1 (OUT)

Board: 2 copper layers, 7 parts (0 on the bottom side), 8 nets, no tracks yet.
