rice-eclipse/AFSElec/IndividualFolders/Alan Bailey/Alans project/Alans project.kicad_pcb

## KiCad design IndividualFolders/Alan Bailey/Alans project/Alans project.kicad_pcb (2026-02-08)

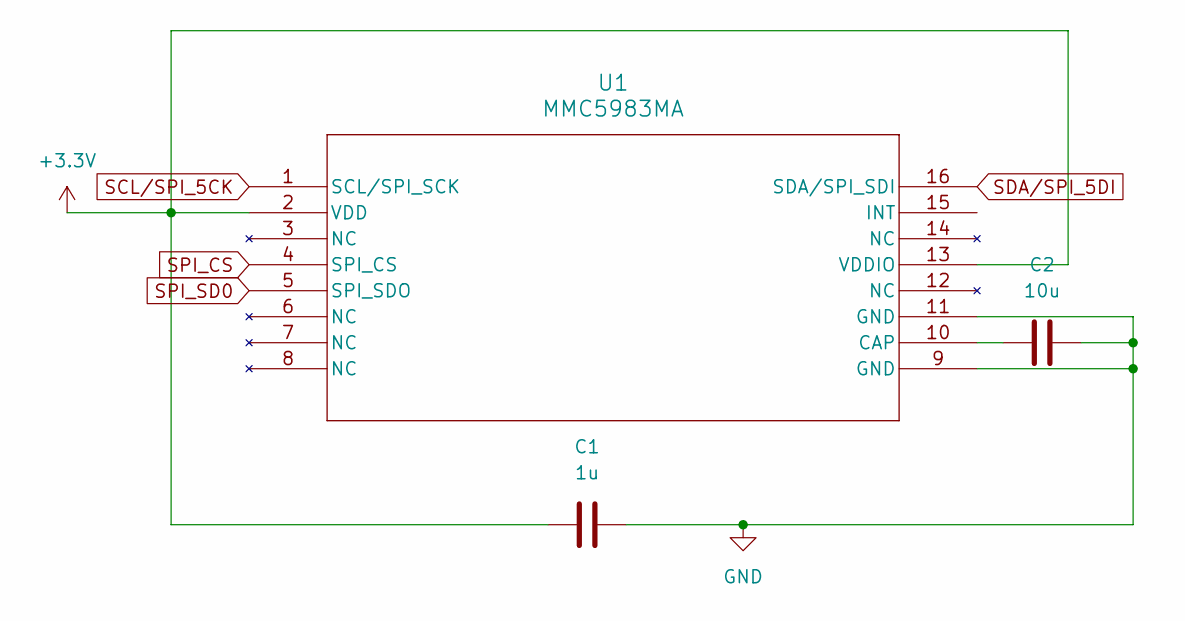
[picture p14: schematic Alans project.kicad_sch]

Parts:
C1: 1u; C_0805_2012Metric
C2: 10u; C_0805_2012Metric
U1: MMC5983MA; LGA-16_3x3mm_P0.5mm

Connections:
+3.3V: C1.1, U1.2 (VDD), U1.13 (VDDIO)
GND: C1.2, C2.2, U1.9 (GND), U1.11 (GND)
unnamed: C2.1, U1.10 (CAP)
SCL/SPI_5CK: U1.1 (SCL/SPI_SCK)
SDA/SPI_5DI: U1.16 (SDA/SPI_SDI)
SPI_CS: U1.4 (SPI_CS)
SPI_SD0: U1.5 (SPI_SDO)

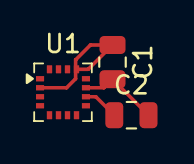
[picture p15: board Alans project.kicad_pcb from above]

Board: 2 copper layers, 3 parts (0 on the bottom side), 3 nets.
