rice-eclipse/AFSElec/IndividualFolders/Reza Rahimzadeh/Reza's Project/KX134/KX134.kicad_pcb

## KiCad design IndividualFolders/Reza Rahimzadeh/Reza's Project/KX134/KX134.kicad_pcb (2026-02-08)

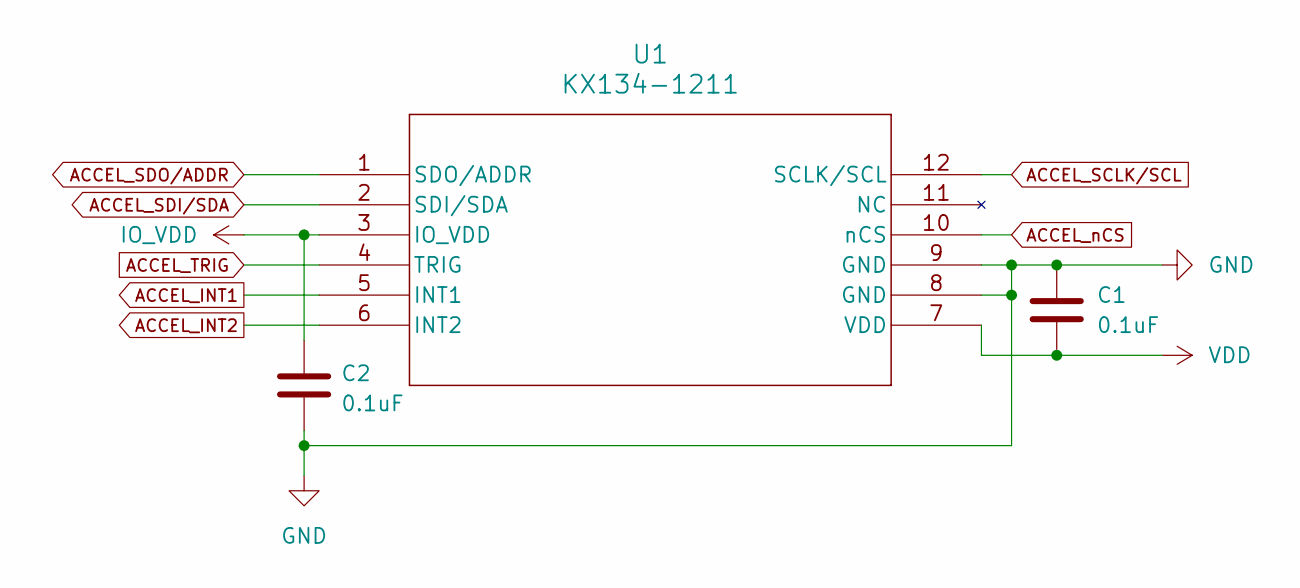
[picture p16: schematic KX134.kicad_sch]

Parts:
C1, C2: 0.1uF; C_0805_2012Metric
U1: KX134-1211; LGA-12_2x2mm_P0.5mm

Connections:
ACCEL_INT1: U1.5 (INT1)
ACCEL_INT2: U1.6 (INT2)
ACCEL_SCLK/SCL: U1.12 (SCLK/SCL)
ACCEL_SDI/SDA: U1.2 (SDI/SDA)
ACCEL_SDO/ADDR: U1.1 (SDO/ADDR)
ACCEL_TRIG: U1.4 (TRIG)
ACCEL_nCS: U1.10 (nCS)
GND: C1.1, C2.2, U1.8 (GND), U1.9 (GND)
IO_VDD: C2.1, U1.3 (IO_VDD)
VDD: C1.2, U1.7 (VDD)

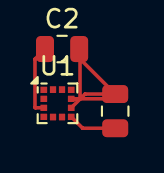
[picture p17: board KX134.kicad_pcb from above]

Board: 2 copper layers, 3 parts (0 on the bottom side), 3 nets.
