rice-eclipse/AFSElec/IndividualFolders/Wilson Harper/INA226/INA226.kicad_sch

## KiCad design IndividualFolders/Wilson Harper/INA226/INA226.kicad_sch (2026-02-08)

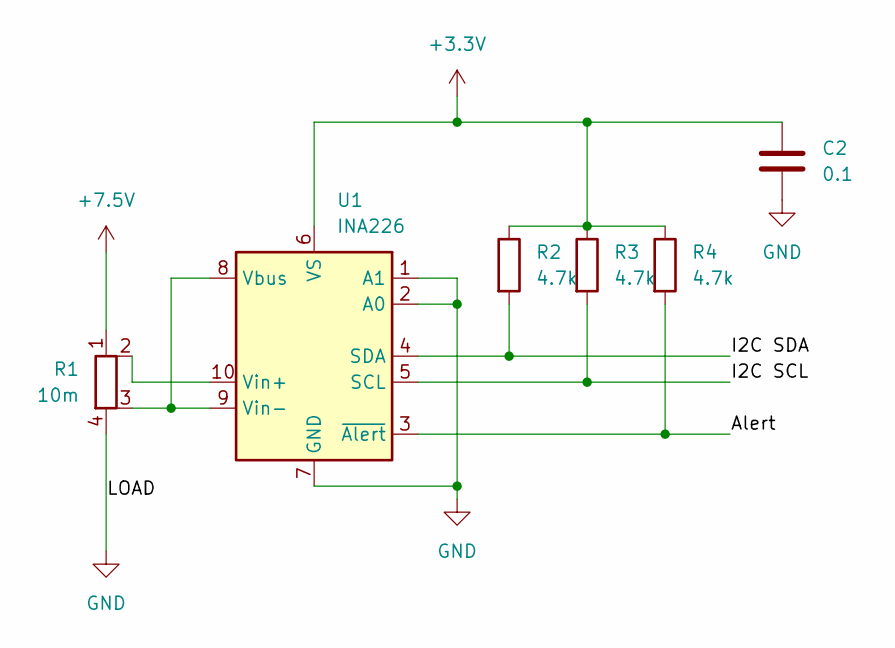
[picture p18: schematic INA226.kicad_sch]

Parts:
C2: 0.1; C_0805_2012Metric
R1: 10m; R_2512_6332Metric
R2, R3, R4: 4.7k; R_0805_2012Metric
U1: INA226; VSSOP-10_3x3mm_P0.5mm

Connections:
+3.3V: C2.1, R2.1, R3.1, R4.1, U1.6 (VS)
+7.5V: R1.1
Alert: R4.2, U1.3 (~Alert)
GND: C2.2, R1.4, U1.1 (A1), U1.2 (A0), U1.7 (GND)
I2C SCL: R3.2, U1.5 (SCL)
I2C SDA: R2.2, U1.4 (SDA)
unnamed: R1.2, U1.10 (Vin+)
unnamed: R1.3, U1.8 (Vbus), U1.9 (Vin-)
