rice-eclipse/AFSElec/(commit log)

2026-01-21 make test file
    [test.kicad_pcb, test.kicad_sch]
2026-01-21 made a change
    [test.kicad_sch]
2026-01-21 said hi to alan
    [test.kicad_sch]
2026-01-21 Added main, Clarified Test
    [AFSElecMain.kicad_pcb, AFSElecMain.kicad_sch, test.kicad_pcb, test.kicad_sch]
2026-01-23 Said Hi
    [AFSElecMain.kicad_sch]
2026-01-23 Wiping Everything
    [AFSElecMain.kicad_pcb, AFSElecMain.kicad_sch, Untitled.kicad_pcb, Untitled.kicad_sch, test.kicad_pcb, test.kicad_sch]
2026-01-23 individual folders
    [landons project.kicad_pcb, landons project.kicad_sch]
2026-01-23 Make Alan's project file
    [Alans project.kicad_pcb, Alans project.kicad_sch]
2026-01-29 Added Logo
    [landons project.kicad_pcb]
2026-02-02 landons changes
    [landons project.kicad_pcb]
2026-02-02 Made the recommended circuit for the MMC5983MA
    [Alans project.kicad_sch]
2026-02-02 Created the recommended circuit for the KX134
    [KX134.kicad_pcb, KX134.kicad_sch]
2026-02-02 Updated KX134 Schematic
    [KX134.kicad_sch]
2026-02-05 Implement INA226 typical application
    [INA226.kicad_pcb, INA226.kicad_sch]
2026-02-05 Update INA226 schematic
    [INA226.kicad_sch]
2026-02-05 implement ms5611 schematic
    I implemented the ms5611 schematic
    [ms5611.kicad_pcb, ms5611.kicad_sch]
2026-02-05 LM75B Schematic
    [Temp Sensor.kicad_pcb, Temp Sensor.kicad_sch]
2026-02-05 Create ICM sensor thing.kicad_sch
    [ICM sensor thing.kicad_sch]
2026-02-05 RP2350 Typical Schematic Added
    [Main.kicad_pcb, Main.kicad_sch]
2026-02-06 Created individual folder
    [Untitled.kicad_pcb, Untitled.kicad_sch]
2026-02-06 mcs1802 current sensor typical application
    sigma sigma
    [MCS1802 schematic.kicad_pcb, MCS1802 schematic.kicad_sch]
2026-02-06 Create Temp Sensor-2026-02-05_181801.zip
    !!!
2026-02-06 Copy schematics to one folder
    [Alans project.kicad_sch, ICM sensor thing.kicad_sch, INA226.kicad_sch, KX134.kicad_sch, Temp Sensor.kicad_sch, landons project.kicad_sch, ms5611.kicad_sch]
2026-02-06 Voltage Regular Schematic
    [Switching Voltage Regulator .kicad_pcb, Switching Voltage Regulator .kicad_sch]
2026-02-08 RENAMED SHIT TO WORK
    [Switching Voltage Regulator.kicad_pcb, Switching Voltage Regulator.kicad_sch]
2026-02-08 add footprint and make basic pcb
    [Alans project.kicad_pcb, Alans project.kicad_sch]
2026-02-08 Select footprint's and make basic PCB for KX134
    [KX134.kicad_pcb, KX134.kicad_sch]
2026-02-08 Assign footprints
    [INA226.kicad_sch]
2026-02-08 Choose footprints for LM2575 power regulator. May need to be changed. HIGH POWER
    [Switching Voltage Regulator.kicad_sch]
2026-02-08 Barometer PCB (and footprints) done
    [ms5611.kicad_pcb, ms5611.kicad_sch]
2026-02-13 Updated footprints
    [Main.kicad_sch]
2026-02-13 Fixes and Additions
    Added current sensors for servos, fixed a few schematics for each chip, and made slight stylistic edits
    [Main.kicad_sch]
2026-02-14 Added servo connectors and micro SD
    [Main.kicad_sch]
2026-02-15 added leds
    [Main.kicad_sch]
2026-02-17 Started Layout
    [Main.kicad_pcb, Main.kicad_sch]
2026-02-17 Layout/Footprint Updates
    updated footprint of inductor for R-Pi, started planning layout for R-PI components in middle of board, added two options for board size
    [Main.kicad_pcb, Main.kicad_sch]
2026-02-17 More RP2350 Footprint
    put more footprints in place(mostly power), updated things to 0402 where possible, and added switching regulator to schematic
    [Main.kicad_pcb, Main.kicad_sch]
2026-02-19 Added 3rd board outline option
    new outline without servo cutouts but with one servo wiring hole
    [Main.kicad_pcb]
2026-02-19 Added shunt footprint and small changes
    [Main.kicad_pcb, Main.kicad_sch]
2026-02-20 updated before meeting
    [Main.kicad_pcb]
2026-02-20 added button footprint
    [Main.kicad_pcb, Main.kicad_sch]
2026-02-20 updated usb footprint
    [Main.kicad_pcb, Main.kicad_sch]
2026-02-20 SD and USB footprint and model updated
    [10118193-0001lfc.stp, Main.kicad_pcb, Main.kicad_sch, Same_Sky_MSD-4-A.step]
2026-02-20 added xt60 connector
    [Main.kicad_pcb, Main.kicad_sch]
2026-02-23 ready for schematic planning
    still no sd card circuit/components for regulator but we can plan more where everything goes
    [Main.kicad_pcb]
2026-02-23 Worked on PCB Layout Prototype
    [Main.kicad_pcb, Main.kicad_sch]
2026-02-23 Individual main
    [10118193-0001lfc.stp, Main.kicad_pcb, Main.kicad_sch, Same_Sky_MSD-4-A.step]
2026-02-23 pls dont break
    [10118193-0001lfc.stp, Main.kicad_pcb, Main.kicad_sch, Same_Sky_MSD-4-A.step]
2026-02-23 Main PCB Layout
    [Main.kicad_pcb, Main.kicad_sch]
2026-02-23 02/22 Reza PCB Design
    [Main.kicad_pcb, Main.kicad_sch]
2026-02-23 changed name to hopefully pull correctly
    [Main.kicad_pcb, Main.kicad_sch]
2026-02-23 added schematic sd card
    [Main.kicad_sch]
2026-02-23 added p-channel mosfet for power control
    USB plugged in -> VBUS high, Vgs on mosfet = 0 -> mosfet off, disconect linear regulator from 3.3v system rails
    [Main.kicad_pcb, Main.kicad_sch]
2026-02-24 changed voltage regulator
    new voltage regulator chip(smaller + more effecient) and supporting components
    [Main.kicad_pcb, Main.kicad_sch]
2026-02-24 some layout stuff
    [Main.kicad_pcb]
2026-02-24 more layout updates and small fixes
    [Main.kicad_pcb, Main.kicad_sch, RP2350A.stp]
2026-02-25 more layout updates
    [Main.kicad_pcb, Main.kicad_sch]
2026-02-26 updated layout
    [Main.kicad_pcb, Main.kicad_sch]
2026-02-26 Power Reg Layout Complete
    [Main.kicad_pcb]
2026-02-27 TPS2121 Schematic & Footprints
    [TPS2121.kicad_pcb, TPS2121.kicad_sch]
2026-02-27 updated power switching schematic
    still need to fix footprint tsp
    [Main.kicad_pcb, Main.kicad_sch]
2026-02-27 make a version of the PCB
    dont think it's right
    [02-25 Main Copy.kicad_pcb, 02-25 Main Copy.kicad_sch, 10118193-0001lfc.stp, RP2350A.stp, Same_Sky_MSD-4-A.step]
2026-02-27 Meeting 2/28/26
    [10118193-0001lfc.stp, Main.kicad_pcb, Main.kicad_sch, RP2350A.stp, Same_Sky_MSD-4-A.step]
2026-02-27 updated power switching circuit
    [Main.kicad_pcb, Main.kicad_sch]
2026-02-27 updated power circuit layout
    [Main.kicad_pcb, Main.kicad_sch]
2026-03-01 Main PCB practice wiring
    [Main.kicad_pcb, Main.kicad_sch]
2026-03-01 idk man
    [Main.kicad_pcb, Main.kicad_sch, RP2350A.stp]
2026-03-01 Wiring Mostly Done
    [Main.kicad_pcb, Main.kicad_sch]
2026-03-01 Add capacitor part numbers
    [Main with Components.kicad_sch]
2026-03-01 Resistor component numbers
    [Main with Components.kicad_sch, Main.kicad_pcb, Main.kicad_sch]
2026-03-01 PART NUMBERSSSSS
    [Main.kicad_pcb, Main.kicad_sch]
2026-03-01 Update Main with Components.kicad_sch
    [Main with Components.kicad_sch]
2026-03-01 Basically Ready
    Yippeeee
    [Main-B_Cu.gbr, Main-B_Mask.gbr, Main-B_Paste.gbr, Main-B_Silkscreen.gbr, Main-Edge_Cuts.gbr, Main-F_Cu.gbr, Main-F_Mask.gbr, Main-F_Paste.gbr]
2026-03-02 changed a few components for manufacturing
    [BOM.csv, Main.kicad_pcb, Main.kicad_sch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]
2026-03-02 Changed resistor values to be basic JLC components
    [Main.kicad_sch]
2026-03-02 lowkey had pwm wire labeled wrong(fixed now)
    [Main.kicad_pcb]
2026-03-03 changed 2 jlcpcb part numbers
    [Main.kicad_sch]
2026-03-03 Added place for serial number
    JLCJLCJLCJLC text is replaced by manufacturer with serial number upon order
    [Main.kicad_pcb]
2026-03-03 added test points
    [BOM.csv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]
2026-03-12 Added some labeled on the schematic
    [Main.kicad_pcb, Main.kicad_sch]
2026-03-26 Added Code
    [Main.kicad_sch]
2026-03-30 update library so that user can set accelerometer and gyroscope range when initalizing the IMU
2026-04-09 Moves the spi transactions to the begin function as this caused errors upon instantiation
    [IMU.cpp]
2026-04-10 Library fixes
    not fully working yet, but progress
    [ICM42688WORKING.ino, IMU.cpp, IMU.h, test_ICM42688.ino]
2026-04-10 zener diode demo
    [DiodeDemo.kicad_pcb, DiodeDemo.kicad_sch]
2026-07-12 Version 2 PCB Begun
    [Version2.kicad_pcb, Version2.kicad_sch]
2026-07-12 Old Changes
    [Main.kicad_pcb, Main.kicad_sch]
2026-08-01 Manufacturable but Needs Thorough Check Through
    [Version2.kicad_pcb, Version2.kicad_sch]
2026-08-07 Small Fixes
    [Version2.kicad_pcb]
2026-08-07 Made Schematic more presentable
    [Version2.kicad_sch]
2026-09-02 Added Test Points + Back Graphics
    [Version2.kicad_pcb, Version2.kicad_sch]
2026-09-03 Updated LCSC Part Numbers
    [Version2-B_Cu.gbr, Version2-B_Mask.gbr, Version2-B_Paste.gbr, Version2-B_Silkscreen.gbr, Version2-Edge_Cuts.gbr, Version2-F_Cu.gbr, Version2-F_Mask.gbr, Version2-F_Paste.gbr]
2026-09-03 Updated Gerbers With Part Numbers
    [Version2-B_Cu.gbr, Version2-B_Mask.gbr, Version2-B_Paste.gbr, Version2-B_Silkscreen.gbr, Version2-Edge_Cuts.gbr, Version2-F_Cu.gbr, Version2-F_Mask.gbr, Version2-F_Paste.gbr]
2026-11-03 Add flight computer firmware with sensor drivers and bench tests
    Pico SDK (RP2350B) project for the main board:
    - lib/: independent drivers for ICM45686 (IMU), KX134 (accel), MMC5983MA
    (mag), MS5611 (baro), TMP117 (temp) and INA219 (power), each with its own
    CMake target and a separate <Name>_test target.
    - MMC5983MA: its always-on I2C interface listens on the shared SCK/MOSI
    lines, so the driver bit-bangs its SPI transfers and sends an I2C STOP
    before each one; hardware SPI gave ~95% product-ID errors, bit-banged 0.
    - Main.cpp: per-test run/verbose flags and a summary table.
    - include/board_pins.h: board GPIO map and bus assignments.
    - BaseHelloWorld: minimal starter project.
    Co-Au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
2026-11-04 Added README for sensor libs
